MrVALIDinfo/Project_Robo_dog/cardboard/README.md

# Картонный макет 1:1

`instrukciya.pdf` — инструкция по сборке, `raskroy_A4.pdf` / `raskroy_A3.pdf` — шаблоны, `laser_svg/` — файлы для лазера.

Печатать в масштабе 100 %. Картон гофрированный, 3 мм. Под другую толщину шаблоны пересчитываются в `tools/cardboard`.
