MrVALIDinfo/Project_Robo_dog/docs/sources/zakupka.pdf

Spot Micro — список закупки | стр. 1

# Spot Micro — список закупки

Робот-собака на Raspberry Pi 3B. Отмечайте купленное в квадратиках.

## 1. Вычисления и сенсоры

| Компонент | Кол-во | Примечание
☐ | Raspberry Pi 3B | 1 | Радиаторы уже установлены
☐ | microSD 8–16 ГБ | 1 | Class 10 / A1
☐ | SSD 240 ГБ M.2 SATA +
| USB-бокс | 1 | Рекомендуется вместо 2.5": компактнее и легче. 2.5" на
| | | пластину не встанет, нужен отдельный кронштейн
☐ | Pi Camera v2 | 1
☐ | Шлейф камеры 20–30 см | 1 | Стандартный 15-pin CSI
☐ | Крепление камеры (печать) | 1 | На пластине нет штатного места
☐ | MPU-6050 (IMU) | 1

## 2. Привод и механика

| Компонент | Кол-во | Примечание
☐ | PCA9685 | 1 | 16-канальный драйвер сервоприводов, I2C
☐ | Сервопривод PDI-HV5523MG | 12
☐ | Удлинители 3-pin | 12 | Длина по месту, для задних и дальних серв
☐ | Печатные детали Spot Micro | 1 компл.
☐ | Подшипник F625zz | 8 | Указан также в таблице крепежа

## 3. Питание

| Компонент | Кол-во | Примечание
☐ | LiPo 2S 4000 мАч | 1
☐ | UBEC 5V / 5A | 1 | Питание Raspberry Pi
☐ | Выключатель (rocker switch) | 1 | Рассчитан на ток не ниже номинала предохранителя
☐ | Разъёмы XT60 | 1 пара
☐ | Y-разветвитель XT60 | 1
☐ | Предохранитель 15–20 А +
| держатель | 1
☐ | Конденсатор 1000–2200 µF | 1 | Напряжение от 16 В, на линию питания серв
☐ | Провод 14–16 AWG | ~1–2 м | Силикон, красный + чёрный
☐ | Зарядное с балансиром | 1 | Для 2S LiPo
☐ | Пищалка разряда | 1 | LiPo low voltage alarm

Spot Micro — список закупки | стр. 2

## 4. Голос

| Компонент | Кол-во | Примечание
☐ | USB-микрофон | 1
☐ | USB-динамик | 1 | Альтернатива: USB-звуковая карта + пассивный динамик с усилителем

## 5. Опционально

| Компонент | Кол-во | Примечание
☐ | LCD 16×2 с I2C-модулем | 1
☐ | ADS1115 | 1 | Замер напряжения батареи

## 6. Крепёж

| Компонент | Кол-во | Примечание
☐ | Болт M5×15 | 8
☐ | Болт M4×20 | 40
☐ | Болт M4×15 | 8
☐ | Гайка M4 | 48
☐ | Болт M3×20 | 4
☐ | Болт M3×10 | 26
☐ | Гайка M3 | 14
☐ | Болт M2.5×10 | 4 | Плата Raspberry Pi
☐ | Гайка M2.5 | 4 | Плата Raspberry Pi
☐ | Винт M2×6 | 4 | Крепление камеры
☐ | Гайка M2 | 4 | Крепление камеры
☐ | Подшипник F625zz | 8
