MrVALIDinfo/Project_Robo_dog/cardboard/raskroy_A3.pdf

Робособака из картона — раскрой 1:1 | Лист 1 из 6 · A3
КОРПУС · деталей на листе: 6 | Картон 3 мм (прорези = 3 мм) · —— резать по контуру · ■ серое — вырезать насквозь · ⊕ отверстие Ø4 под шпажку · - - - разметка, не резать

КОНТРОЛЬ: ровно 100 мм. Печатать в масштабе 100% («Фактический размер») Сторона с надписью — НАРУЖУ (на собранной модели надпись видна). github.com/MrVALIDinfo/Project_Robo_dog

К4

# Крыша (съёмная)

### к носу

К3

# Днище

### к носу

К6

# Нос нижний

К8

# Корма нижняя

# ALA-TOO

К5

## Нос верхний

К7
Корма верхняя

Робособака из картона — раскрой 1:1 | Лист 2 из 6 · A3
КОРПУС · деталей на листе: 4 | Картон 3 мм (прорези = 3 мм) · —— резать по контуру · ■ серое — вырезать насквозь · ⊕ отверстие Ø4 под шпажку · - - - разметка, не резать

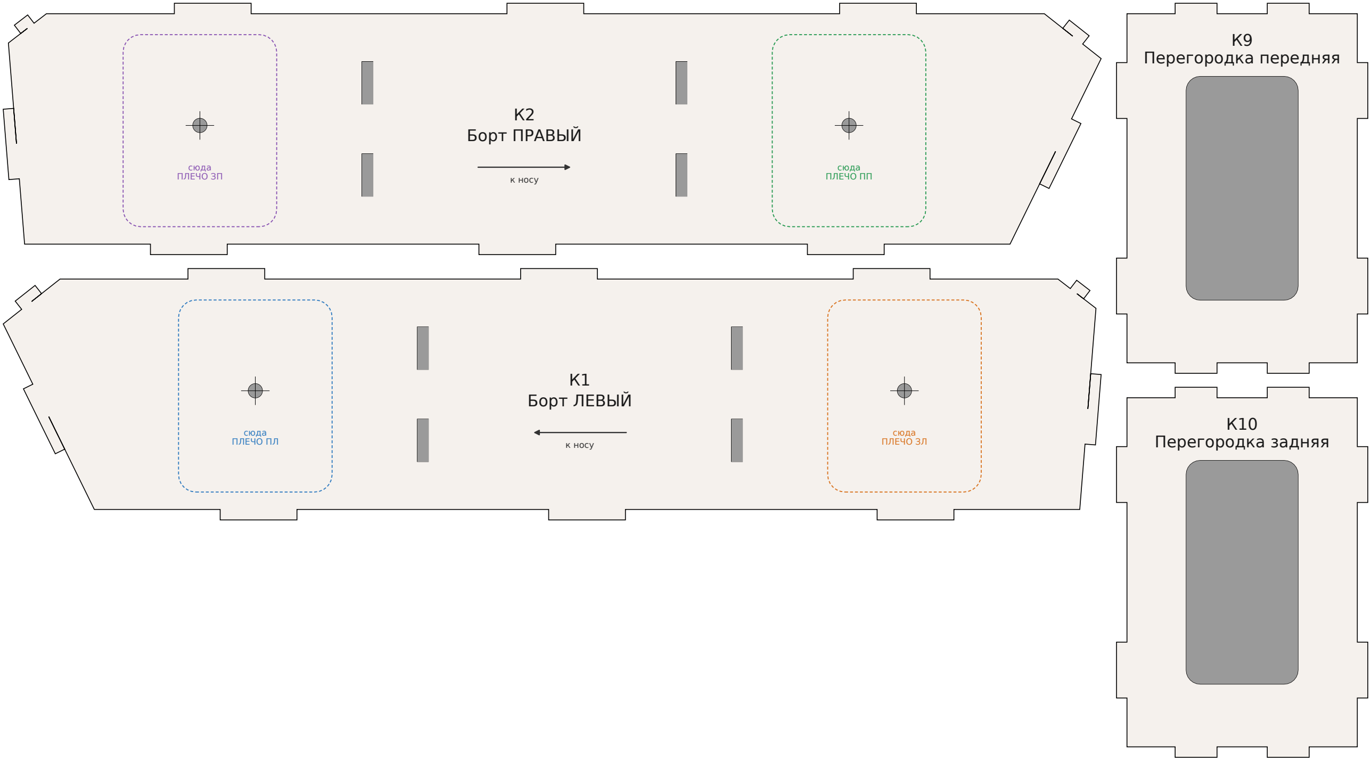
[picture p14: figure]
сюда ПЛЕЧО ПП; сюда ПЛЕЧО ЗП; К2 Борт ПРАВЫЙ; к носу; сюда ПЛЕЧО ПЛ; сюда ПЛЕЧО ЗЛ; К1 Борт ЛЕВЫЙ; К9 Перегородка передняя; К10 Перегородка задняя

Робособака из картона — раскрой 1:1 | Лист 3 из 6 · A3
ПЕРЕДНЯЯ ЛЕВАЯ лапа (ПЛ) · деталей на листе: 21 | Картон 3 мм (прорези = 3 мм) · —— резать по контуру · ■ серое — вырезать насквозь · ⊕ отверстие Ø4 под шпажку · - - - разметка, не резать

## ПЛ-Б1 Бедро, внутренняя передняя ЛЕВАЯ

## ПЛ-Б2

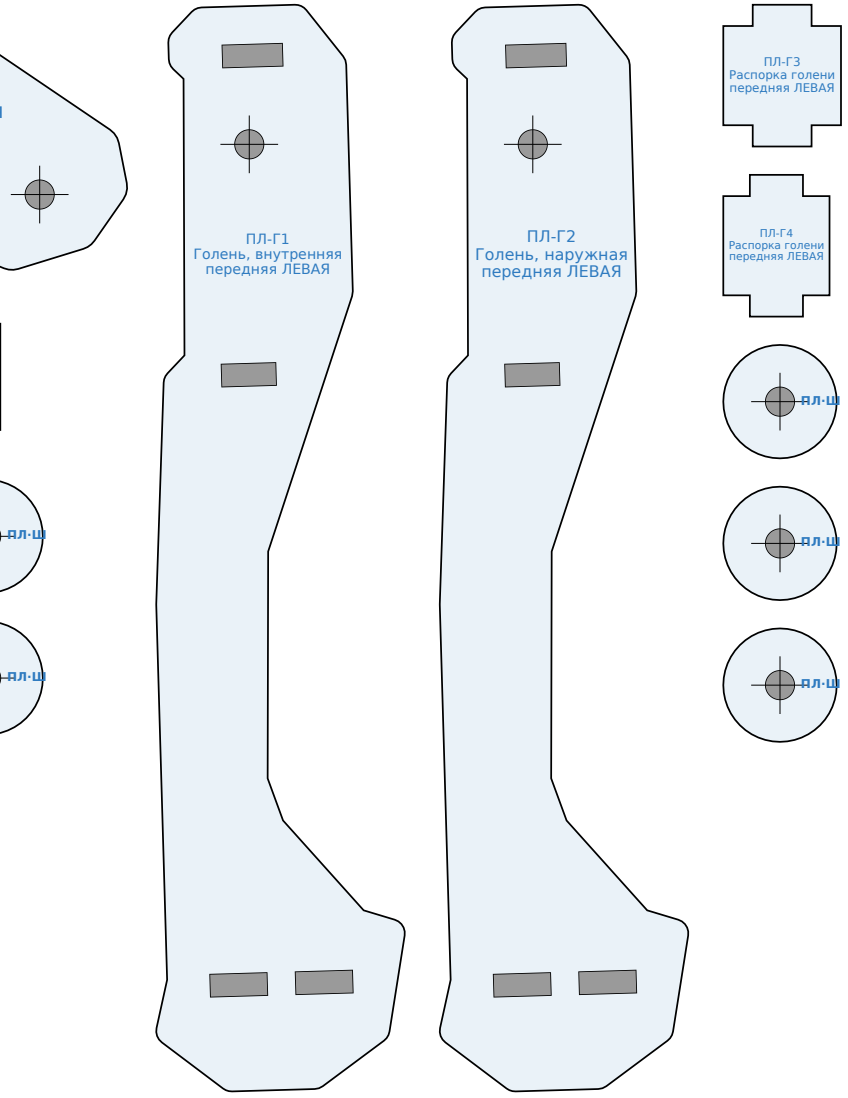
[picture p15: figure]
ПЛ-Г1 Голень, внутренняя передняя ЛЕВАЯ; ПЛ-Г2 Голень, наружная передняя ЛЕВАЯ; ПЛ-Г3 Распорка голени передняя ЛЕВАЯ; ПЛ-Г4 Распорка голени передняя ЛЕВАЯ

## Бедро, наружная передняя ЛЕВАЯ

## ПЛ-П1 Плечо, к корпусу передняя ЛЕВАЯ

## ПЛ-П2 Плечо, наружная передняя ЛЕВАЯ

## ПЛ-Б5 Распорка бедра передняя ЛЕВАЯ

## ПЛ-Б4 Распорка бедра передняя ЛЕВАЯ

## ПЛ-П3 Распорка плеча передняя ЛЕВАЯ

## ПЛ-П4 Распорка плеча передняя ЛЕВАЯ

## ПЛ-Б3 Распорка бедра передняя ЛЕВАЯ

## ПЛ-Г5 Распорка голени передняя ЛЕВАЯ

ПЛ·Ш
ПЛ·Ш

Робособака из картона — раскрой 1:1 | Лист 4 из 6 · A3
ПЕРЕДНЯЯ ПРАВАЯ лапа (ПП) · деталей на листе: 21 | Картон 3 мм (прорези = 3 мм) · —— резать по контуру · ■ серое — вырезать насквозь · ⊕ отверстие Ø4 под шпажку · - - - разметка, не резать

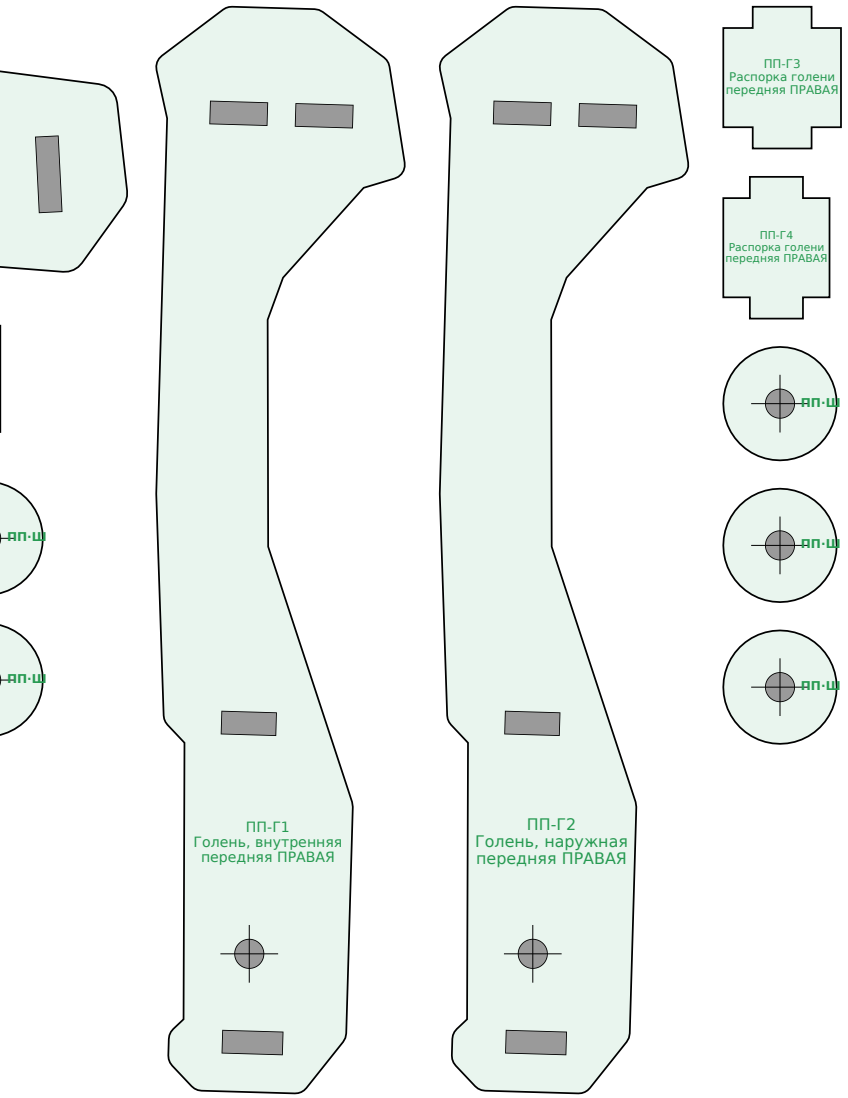
[picture p16: figure]
ПП-Г1 Голень, внутренняя передняя ПРАВАЯ; ПП-Г2 Голень, наружная передняя ПРАВАЯ; ПП-Г3 Распорка голени передняя ПРАВАЯ; ПП-Г4 Распорка голени передняя ПРАВАЯ

## ПП-Б1 Бедро, внутренняя передняя ПРАВАЯ

## ПП-Б2 Бедро, наружная передняя ПРАВАЯ

## ПП-П1 Плечо, к корпусу передняя ПРАВАЯ

## ПП-П2 Плечо, наружная передняя ПРАВАЯ

## ПП-Б5 Распорка бедра передняя ПРАВАЯ

## ПП-Б4 Распорка бедра передняя ПРАВАЯ

## ПП-П3 Распорка плеча передняя ПРАВАЯ

## ПП-П4 Распорка плеча передняя ПРАВАЯ

## ПП-Б3 Распорка бедра передняя ПРАВАЯ

## ПП-Г5 Распорка голени передняя ПРАВАЯ

ПП·Ш
ПП·Ш

Робособака из картона — раскрой 1:1 | Лист 5 из 6 · A3
ЗАДНЯЯ ЛЕВАЯ лапа (ЗЛ) · деталей на листе: 21 | Картон 3 мм (прорези = 3 мм) · —— резать по контуру · ■ серое — вырезать насквозь · ⊕ отверстие Ø4 под шпажку · - - - разметка, не резать

## ЗЛ-Б1 Бедро, внутренняя задняя ЛЕВАЯ

## ЗЛ-Б2

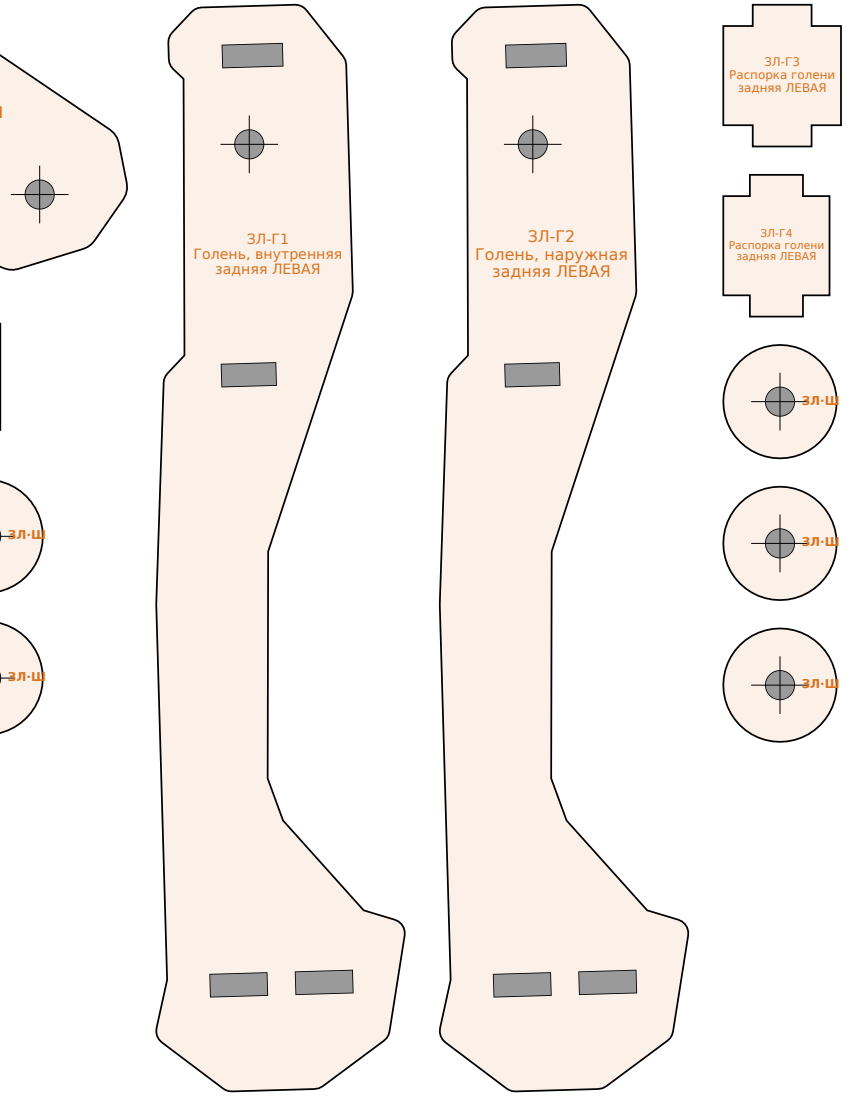
[picture p17: figure]
ЗЛ-Г1 Голень, внутренняя задняя ЛЕВАЯ; ЗЛ-Г2 Голень, наружная задняя ЛЕВАЯ; ЗЛ-Г3 Распорка голени задняя ЛЕВАЯ; ЗЛ-Г4 Распорка голени задняя ЛЕВАЯ

## Бедро, наружная задняя ЛЕВАЯ

## ЗЛ-П1 Плечо, к корпусу задняя ЛЕВАЯ

## ЗЛ-П2 Плечо, наружная задняя ЛЕВАЯ

## ЗЛ-Б5 Распорка бедра задняя ЛЕВАЯ

## ЗЛ-Б4 Распорка бедра задняя ЛЕВАЯ

## ЗЛ-П3 Распорка плеча задняя ЛЕВАЯ

## ЗЛ-П4 Распорка плеча задняя ЛЕВАЯ

## ЗЛ-Б3 Распорка бедра задняя ЛЕВАЯ

## ЗЛ-Г5 Распорка голени задняя ЛЕВАЯ

ЗЛ·Ш
ЗЛ·Ш

Робособака из картона — раскрой 1:1 | Лист 6 из 6 · A3
ЗАДНЯЯ ПРАВАЯ лапа (ЗП) · деталей на листе: 21 | Картон 3 мм (прорези = 3 мм) · —— резать по контуру · ■ серое — вырезать насквозь · ⊕ отверстие Ø4 под шпажку · - - - разметка, не резать

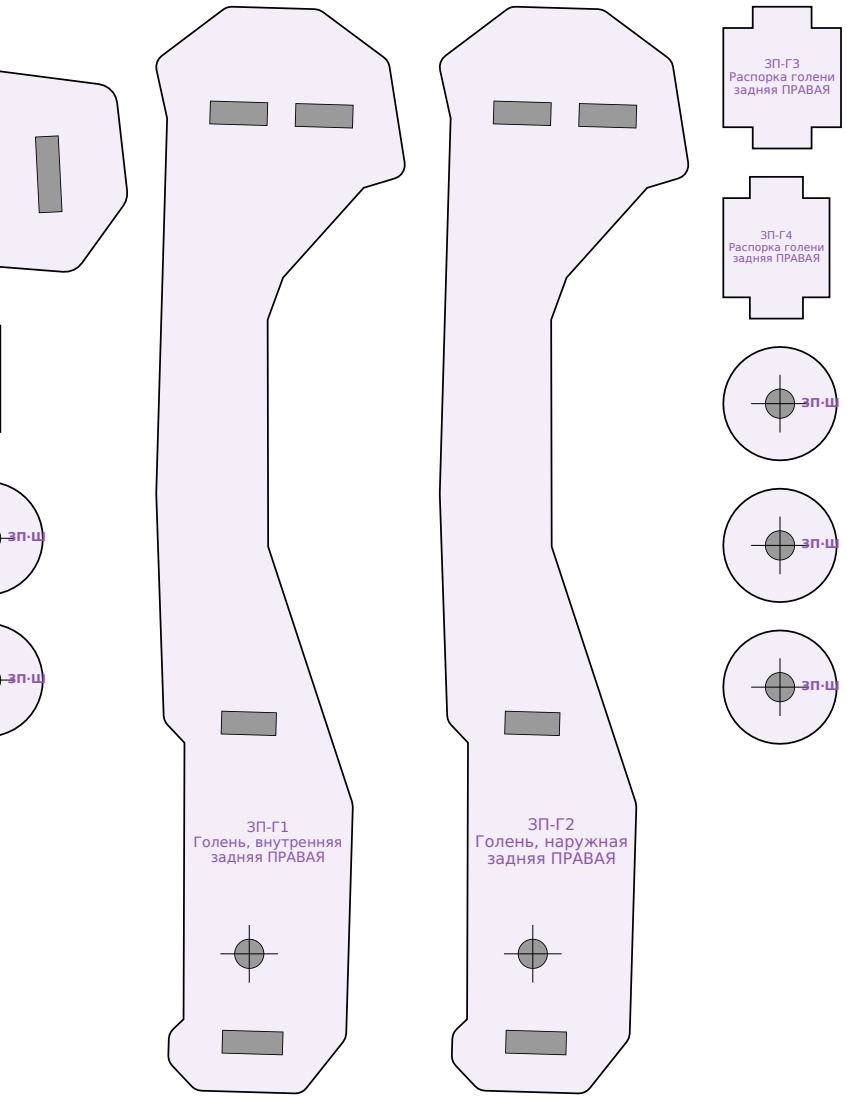
[picture p18: figure]
ЗП-Г1 Голень, внутренняя задняя ПРАВАЯ; ЗП-Г2 Голень, наружная задняя ПРАВАЯ; ЗП-Г3 Распорка голени задняя ПРАВАЯ; ЗП-Г4 Распорка голени задняя ПРАВАЯ

## ЗП-Б1 Бедро, внутренняя задняя ПРАВАЯ

## ЗП-Б2 Бедро, наружная задняя ПРАВАЯ

## ЗП-П1 Плечо, к корпусу задняя ПРАВАЯ

## ЗП-П2 Плечо, наружная задняя ПРАВАЯ

## ЗП-Б5 Распорка бедра задняя ПРАВАЯ

## ЗП-Б4 Распорка бедра задняя ПРАВАЯ

## ЗП-П3 Распорка плеча задняя ПРАВАЯ

## ЗП-П4 Распорка плеча задняя ПРАВАЯ

## ЗП-Б3 Распорка бедра задняя ПРАВАЯ

## ЗП-Г5 Распорка голени задняя ПРАВАЯ

ЗП·Ш
ЗП·Ш
