MrVALIDinfo/Project_Robo_dog/cardboard/raskroy_A4.pdf

Робособака из картона — раскрой 1:1 | Лист 1 из 9 · A4
КОРПУС · деталей на листе: 4 | Картон 3 мм (прорези = 3 мм) · —— резать по контуру · ■ серое — вырезать насквозь · ⊕ отверстие Ø4 под шпажку · - - - разметка, не резать

КОНТРОЛЬ: ровно 100 мм. Печатать в масштабе 100% («Фактический размер») Сторона с надписью — НАРУЖУ (на собранной модели надпись видна). github.com/MrVALIDinfo/Project_Robo_dog

СТЫК с частью 2/2 — не резать, склеить скотчем

К4 (1/2)

# Крыша (съёмная)

### к носу

К6

# Нос нижний

К5

## Нос верхний

К7
Корма верхняя

Робособака из картона — раскрой 1:1 | Лист 2 из 9 · A4
КОРПУС · деталей на листе: 2 | Картон 3 мм (прорези = 3 мм) · —— резать по контуру · ■ серое — вырезать насквозь · ⊕ отверстие Ø4 под шпажку · - - - разметка, не резать

СТЫК с частью 2/2 — не резать, склеить скотчем

К3 (1/2)

# Днище

### к носу

К8

# Корма нижняя

# ALA-TOO

Робособака из картона — раскрой 1:1 | Лист 3 из 9 · A4
КОРПУС · деталей на листе: 2 | Картон 3 мм (прорези = 3 мм) · —— резать по контуру · ■ серое — вырезать насквозь · ⊕ отверстие Ø4 под шпажку · - - - разметка, не резать

Сторона с надписью — НАРУЖУ (на собранной модели надпись видна). github.com/MrVALIDinfo/Project_Robo_dog СТЫК с частью ¹/2 — не резать, склеить скотчем

К4 (2/2)

# Крыша (съёмная)

### к носу

СТЫК с частью 1/2 — не резать, склеить скотчем

К3 (2/2)

# Днище

### к носу

Робособака из картона — раскрой 1:1 | Лист 4 из 9 · A4
КОРПУС · деталей на листе: 4 | Картон 3 мм (прорези = 3 мм) · —— резать по контуру · ■ серое — вырезать насквозь · ⊕ отверстие Ø4 под шпажку · - - - разметка, не резать

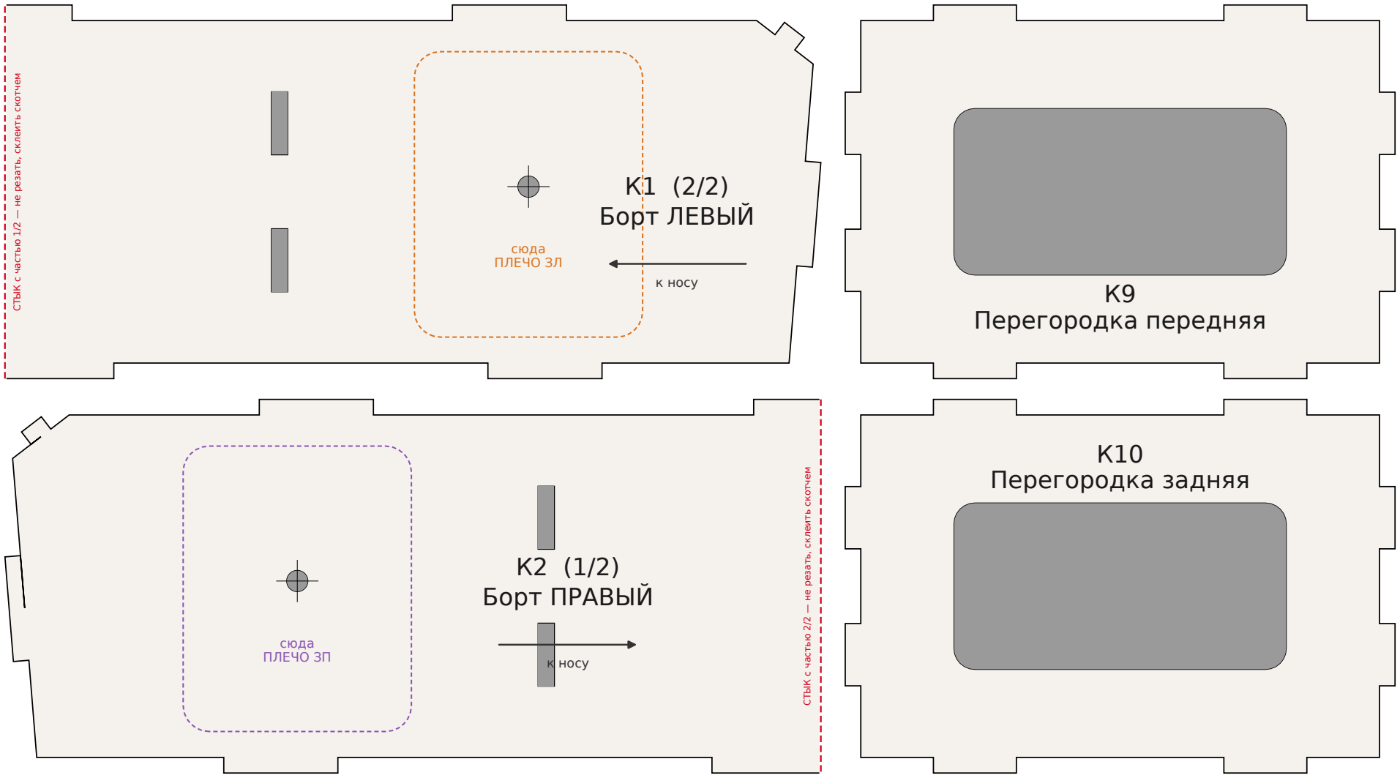
[picture p19: figure]
сюда ПЛЕЧО ЗЛ; К1 (2/2) Борт ЛЕВЫЙ; к носу; сюда ПЛЕЧО ЗП; К2 (1/2) Борт ПРАВЫЙ; К9 Перегородка передняя; К10 Перегородка задняя

СТЫК с частью 1/2 — не резать, склеить скотчем

СТЫК с частью 2/2 — не резать, склеить скотчем

Робособака из картона — раскрой 1:1 | Лист 5 из 9 · A4
КОРПУС · деталей на листе: 2 | Картон 3 мм (прорези = 3 мм) · —— резать по контуру · ■ серое — вырезать насквозь · ⊕ отверстие Ø4 под шпажку · - - - разметка, не резать

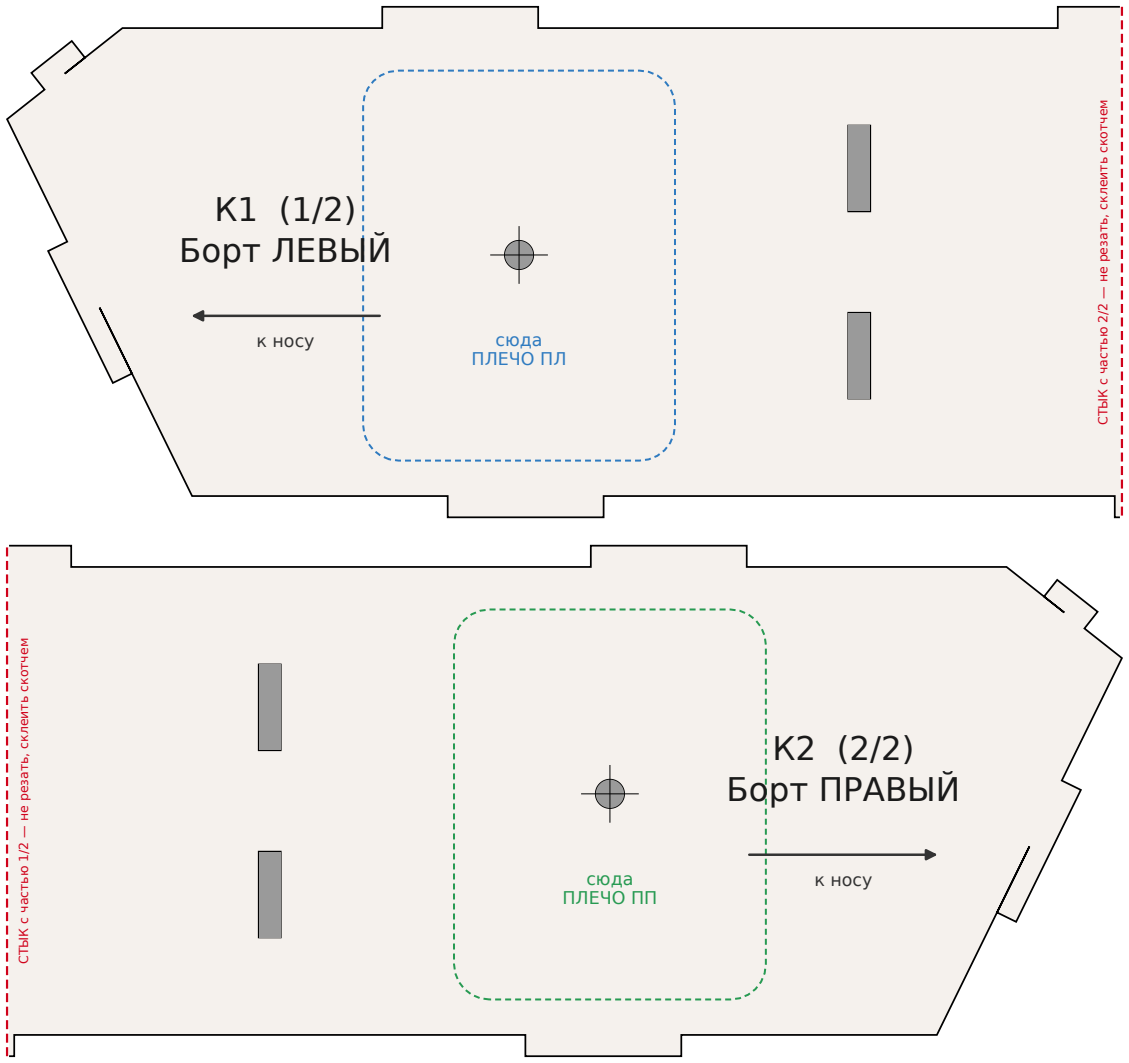
[picture p20: figure]
сюда ПЛЕЧО ПЛ; К1 (1/2) Борт ЛЕВЫЙ; к носу; сюда ПЛЕЧО ПП; К2 (2/2) Борт ПРАВЫЙ

СТЫК с частью 2/2 — не резать, склеить скотчем

СТЫК с частью 1/2 — не резать, склеить скотчем

Робособака из картона — раскрой 1:1 | Лист 6 из 9 · A4
ПЕРЕДНЯЯ ЛЕВАЯ лапа (ПЛ) · деталей на листе: 21 | Картон 3 мм (прорези = 3 мм) · —— резать по контуру · ■ серое — вырезать насквозь · ⊕ отверстие Ø4 под шпажку · - - - разметка, не резать

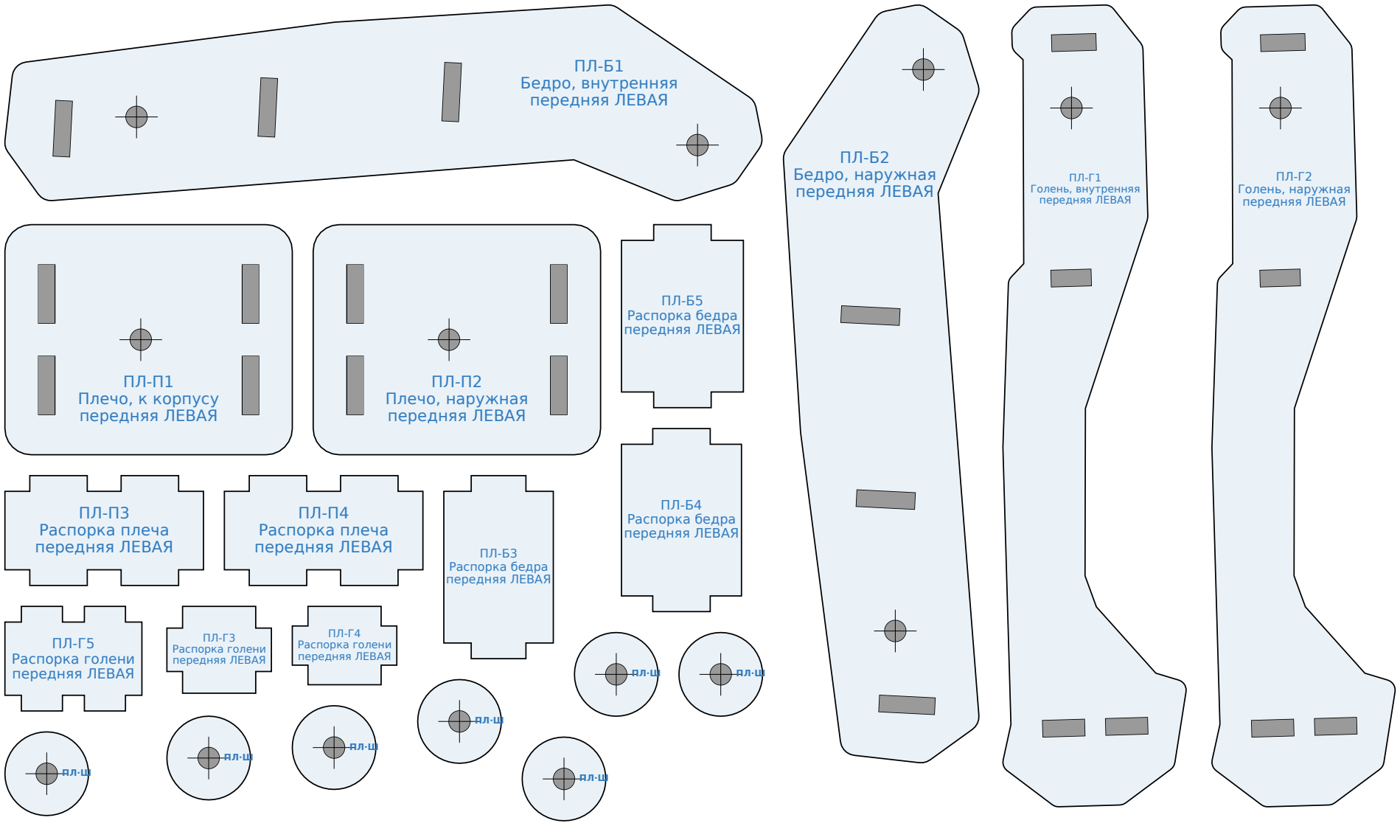
[picture p21: figure]
ПЛ-Б1 Бедро, внутренняя передняя ЛЕВАЯ; ПЛ-Б2 Бедро, наружная передняя ЛЕВАЯ; ПЛ-Г1 Голень, внутренняя передняя ЛЕВАЯ; ПЛ-Г2 Голень, наружная передняя ЛЕВАЯ; ПЛ-П1 Плечо, к корпусу передняя ЛЕВАЯ; ПЛ-П2 Плечо, наружная передняя ЛЕВАЯ; ПЛ-Б5 Распорка бедра передняя ЛЕВАЯ; ПЛ-Б4 Распорка бедра передняя ЛЕВАЯ; ПЛ-П3 Распорка плеча передняя ЛЕВАЯ; ПЛ-П4 Распорка плеча; передняя ЛЕВАЯ; Распорка бедра передняя ЛЕВАЯ; ПЛ-Г5 Распорка голени передняя ЛЕВАЯ; ПЛ-Г3 Распорка голени передняя ЛЕВАЯ; ПЛ-Г4 Распорка голени передняя ЛЕВАЯ

Робособака из картона — раскрой 1:1 | Лист 7 из 9 · A4
ПЕРЕДНЯЯ ПРАВАЯ лапа (ПП) · деталей на листе: 21 | Картон 3 мм (прорези = 3 мм) · —— резать по контуру · ■ серое — вырезать насквозь · ⊕ отверстие Ø4 под шпажку · - - - разметка, не резать

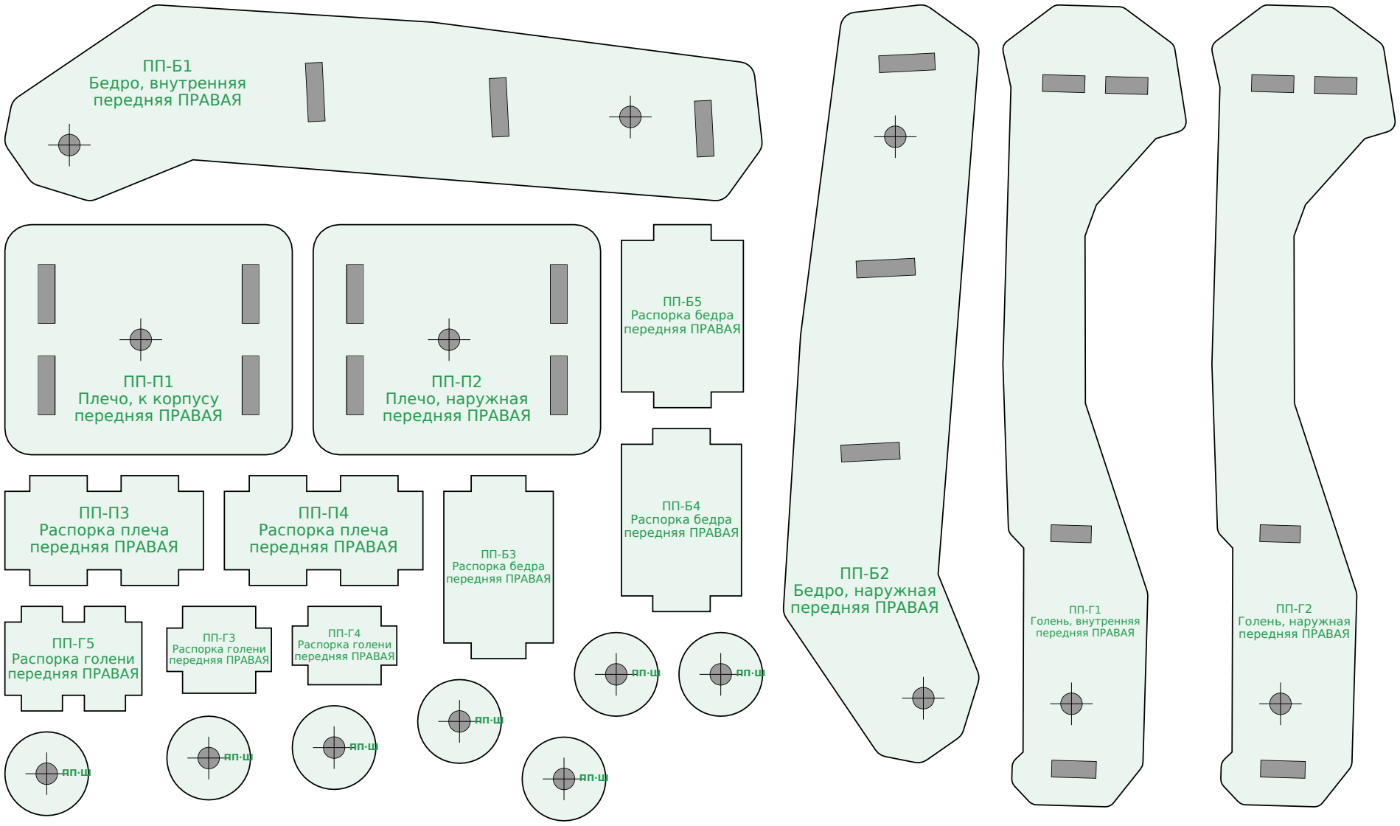
[picture p22: figure]
ПП-Б1 Бедро, внутренняя передняя ПРАВАЯ; ПП-Б2 Бедро, наружная; передняя ПРАВАЯ; Голень, внутренняя передняя ПРАВАЯ; ПП-Г2 Голень, наружная передняя ПРАВАЯ; ПП-П1 Плечо, к корпусу передняя ПРАВАЯ; ПП-П2 Плечо, наружная передняя ПРАВАЯ; ПП-Б5 Распорка бедра передняя ПРАВАЯ; ПП-Б4 Распорка бедра передняя ПРАВАЯ; ПП-П3 Распорка плеча передняя ПРАВАЯ; ПП-П4 Распорка плеча; Распорка бедра передняя ПРАВАЯ; ПП-Г5 Распорка голени передняя ПРАВАЯ; ПП-Г3 Распорка голени передняя ПРАВАЯ; ПП-Г4 Распорка голени передняя ПРАВАЯ

Робособака из картона — раскрой 1:1 | Лист 8 из 9 · A4
ЗАДНЯЯ ЛЕВАЯ лапа (ЗЛ) · деталей на листе: 21 | Картон 3 мм (прорези = 3 мм) · —— резать по контуру · ■ серое — вырезать насквозь · ⊕ отверстие Ø4 под шпажку · - - - разметка, не резать

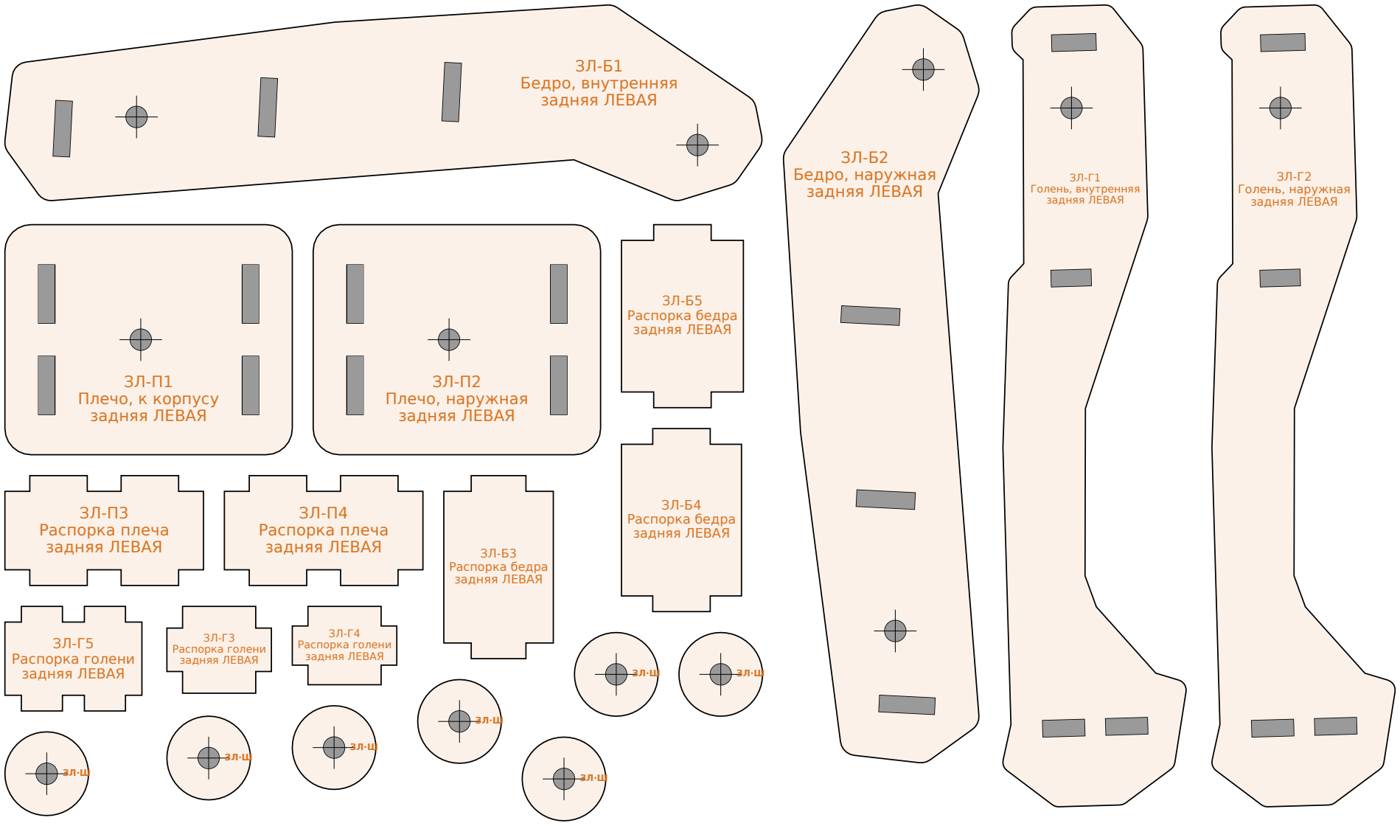
[picture p23: figure]
ЗЛ-Б1 Бедро, внутренняя задняя ЛЕВАЯ; ЗЛ-Б2 Бедро, наружная задняя ЛЕВАЯ; ЗЛ-Г1 Голень, внутренняя задняя ЛЕВАЯ; ЗЛ-Г2 Голень, наружная задняя ЛЕВАЯ; ЗЛ-П1 Плечо, к корпусу задняя ЛЕВАЯ; ЗЛ-П2 Плечо, наружная задняя ЛЕВАЯ; ЗЛ-Б5 Распорка бедра задняя ЛЕВАЯ; ЗЛ-Б4 Распорка бедра задняя ЛЕВАЯ; ЗЛ-П3 Распорка плеча задняя ЛЕВАЯ; ЗЛ-П4 Распорка плеча; задняя ЛЕВАЯ; Распорка бедра задняя ЛЕВАЯ; ЗЛ-Г5 Распорка голени задняя ЛЕВАЯ; ЗЛ-Г3 Распорка голени задняя ЛЕВАЯ; ЗЛ-Г4 Распорка голени задняя ЛЕВАЯ

Робособака из картона — раскрой 1:1 | Лист 9 из 9 · A4
ЗАДНЯЯ ПРАВАЯ лапа (ЗП) · деталей на листе: 21 | Картон 3 мм (прорези = 3 мм) · —— резать по контуру · ■ серое — вырезать насквозь · ⊕ отверстие Ø4 под шпажку · - - - разметка, не резать

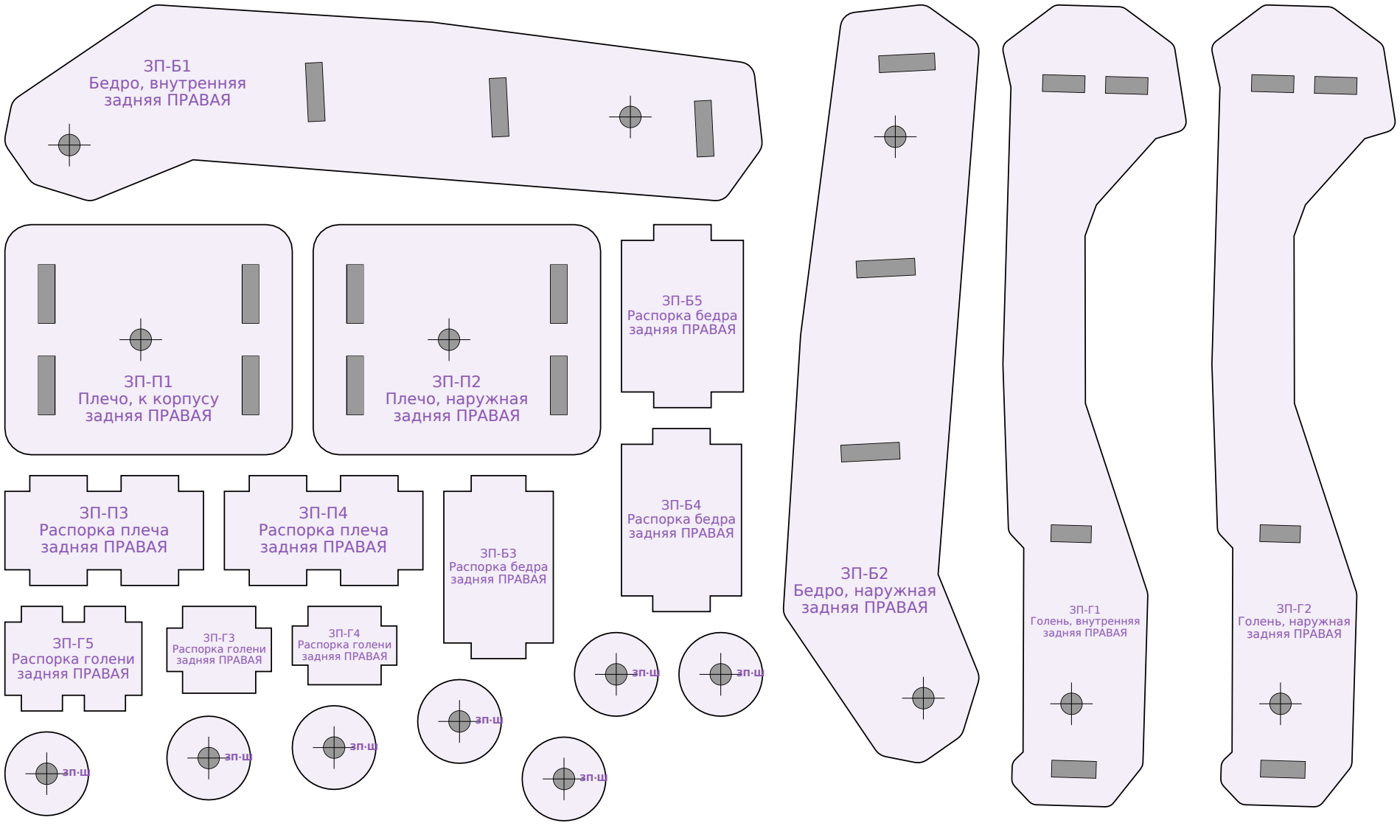
[picture p24: figure]
ЗП-Б1 Бедро, внутренняя задняя ПРАВАЯ; ЗП-Б2 Бедро, наружная; задняя ПРАВАЯ; Голень, внутренняя задняя ПРАВАЯ; ЗП-Г2 Голень, наружная задняя ПРАВАЯ; ЗП-П1 Плечо, к корпусу задняя ПРАВАЯ; ЗП-П2 Плечо, наружная задняя ПРАВАЯ; ЗП-Б5 Распорка бедра задняя ПРАВАЯ; ЗП-Б4 Распорка бедра задняя ПРАВАЯ; ЗП-П3 Распорка плеча задняя ПРАВАЯ; ЗП-П4 Распорка плеча; Распорка бедра задняя ПРАВАЯ; ЗП-Г5 Распорка голени задняя ПРАВАЯ; ЗП-Г3 Распорка голени задняя ПРАВАЯ; ЗП-Г4 Распорка голени задняя ПРАВАЯ
