MrVALIDinfo/Project_Robo_dog/docs/arduino-led-circuit.png

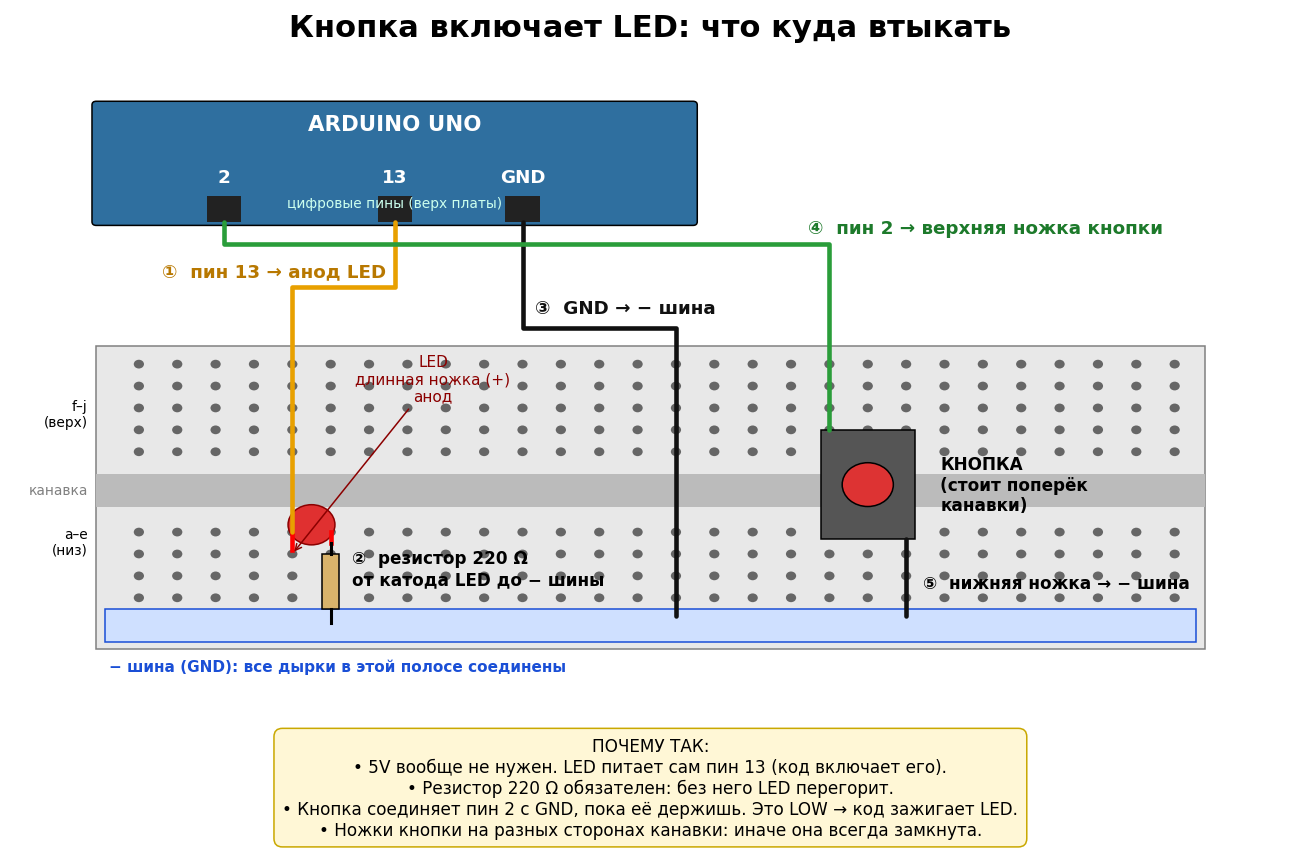
docs/arduino-led-circuit.png
