MrVALIDinfo/Project_Robo_dog/3d-viewer/stl/parts/mainbody__5__R_side_plate.stl

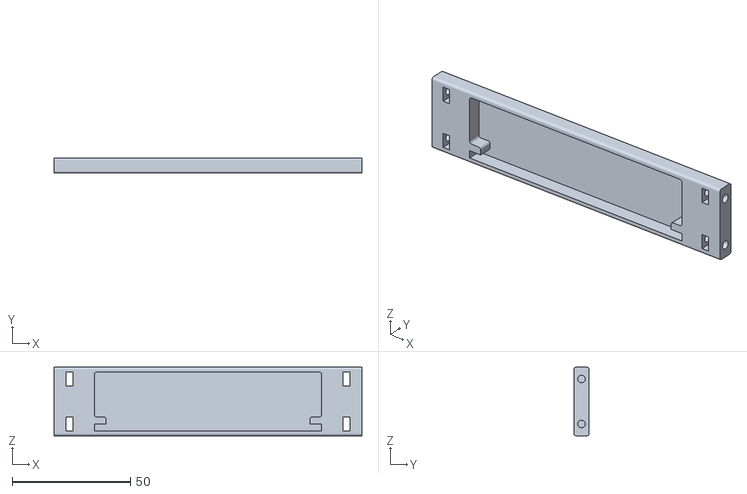
[picture p26: CAD file, 2026-10-31]
3d-viewer/stl/parts/mainbody__5__R_side_plate.stl
130.0 x 6.50 x 29.0
