MrVALIDinfo/Project_Robo_dog/3d-viewer/stl/parts/mainbody__6__plate_plain.stl

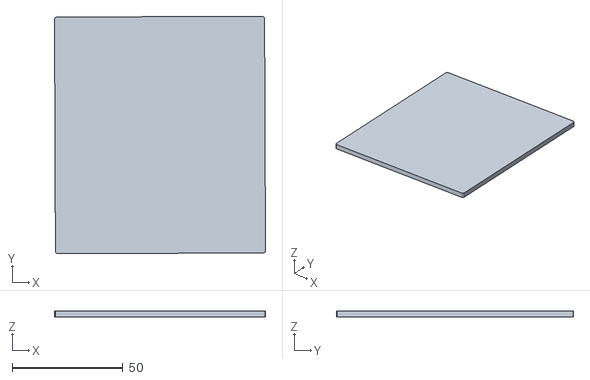
[picture p27: CAD file, 2026-10-31]
3d-viewer/stl/parts/mainbody__6__plate_plain.stl
95.4 x 107.4 x 2.90
