MrVALIDinfo/Project_Robo_dog/3d-viewer/stl/kdy/mainbody.stl

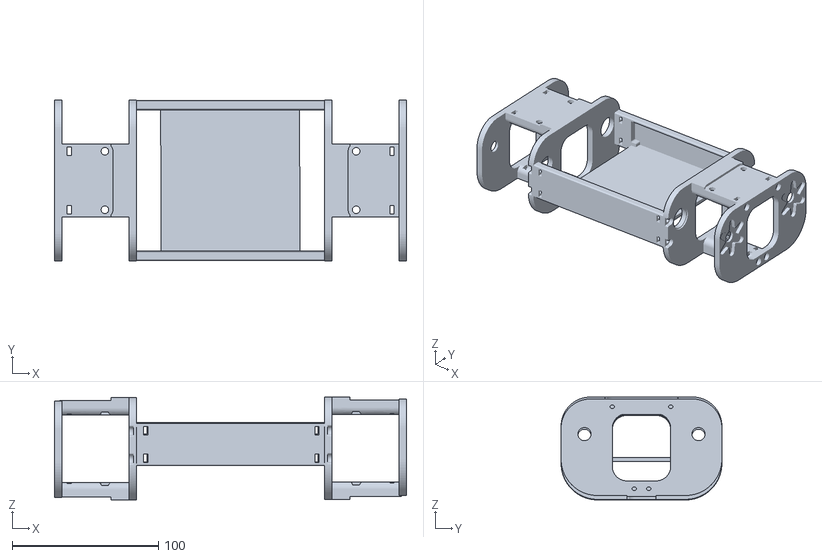
[picture p28: CAD file, 2026-10-30]
3d-viewer/stl/kdy/mainbody.stl
240.7 x 110.0 x 70.4
