MrVALIDinfo/Project_Robo_dog/3d-viewer/stl/parts/mainbody__2__O_shoulder.stl

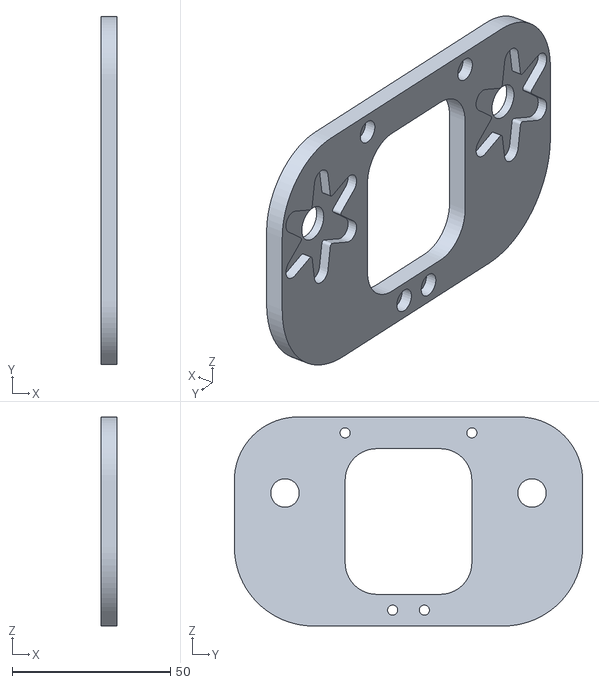
[picture p29: CAD file, 2026-10-31]
3d-viewer/stl/parts/mainbody__2__O_shoulder.stl
5.00 x 110.0 x 66.0
