MrVALIDinfo/Project_Robo_dog/3d-viewer/stl/parts/mainbody__0__I_shoulder_cls.stl

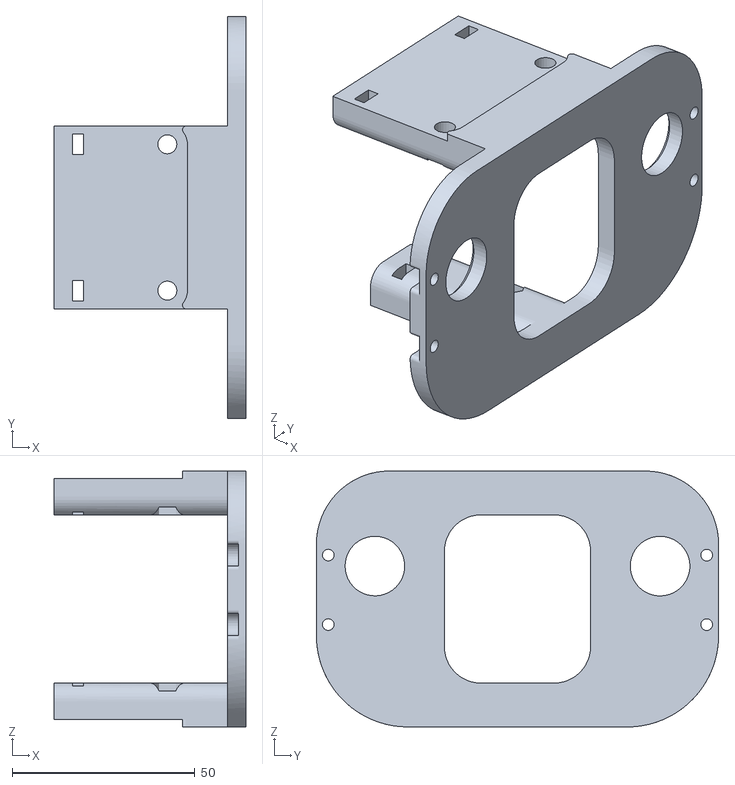
[picture p30: CAD file, 2026-10-31]
3d-viewer/stl/parts/mainbody__0__I_shoulder_cls.stl
52.5 x 110.0 x 70.0
