MrVALIDinfo/Project_Robo_dog/3d-viewer/parts/rpi3.stl

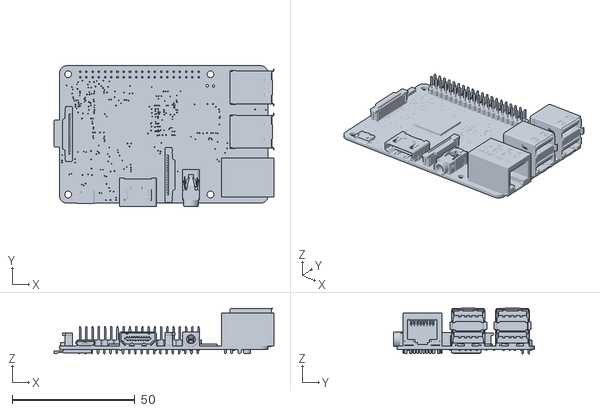
[picture p31: CAD file, 2026-10-31]
3d-viewer/parts/rpi3.stl
89.6 x 57.3 x 18.6
