MrVALIDinfo/Project_Robo_dog/3d-viewer/stl/backpart_filled.stl

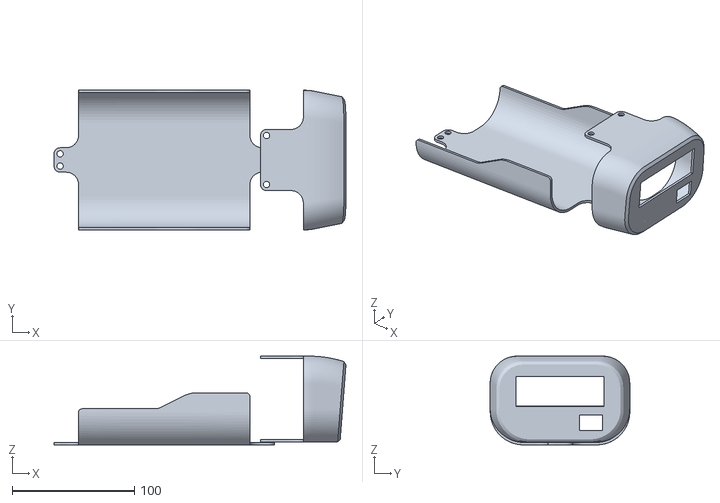
[picture p32: CAD file, 2026-10-26]
3d-viewer/stl/backpart_filled.stl
238.4 x 114.1 x 72.5
