MrVALIDinfo/Project_Robo_dog/3d-viewer/stl/parts/frontpart__1__F_cover.stl

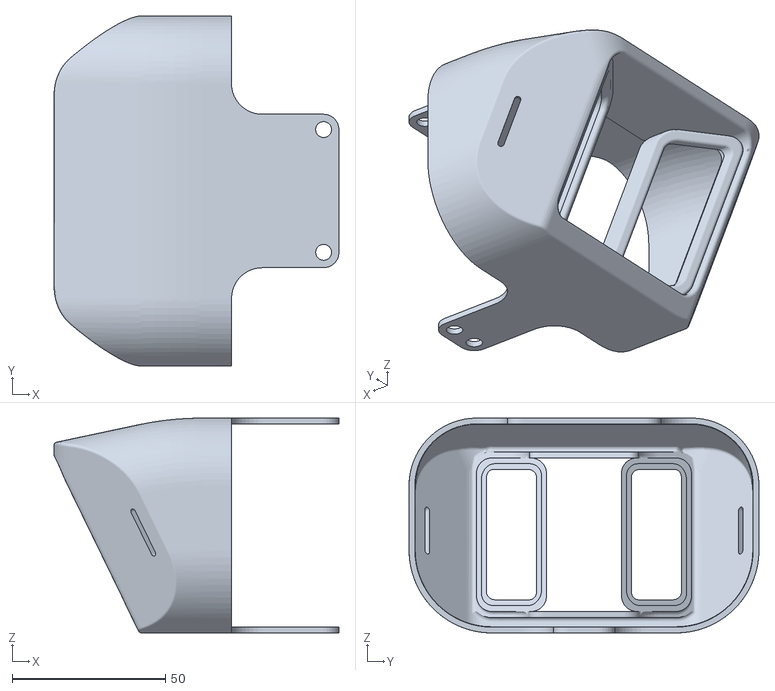
[picture p33: CAD file, 2026-10-31]
3d-viewer/stl/parts/frontpart__1__F_cover.stl
92.8 x 114.0 x 70.0
