MrVALIDinfo/Project_Robo_dog/print/kdy/L_arm_cls_cable.stl

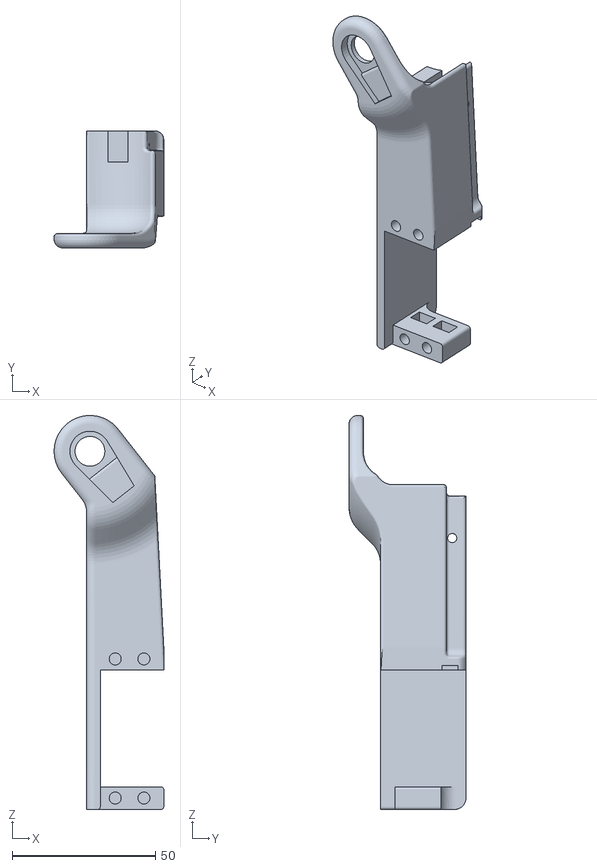
[picture p34: CAD file, 2026-10-30]
print/kdy/L_arm_cls_cable.stl
38.2 x 40.8 x 137.4
