MrVALIDinfo/Project_Robo_dog/print/R_cover_alatoo.stl

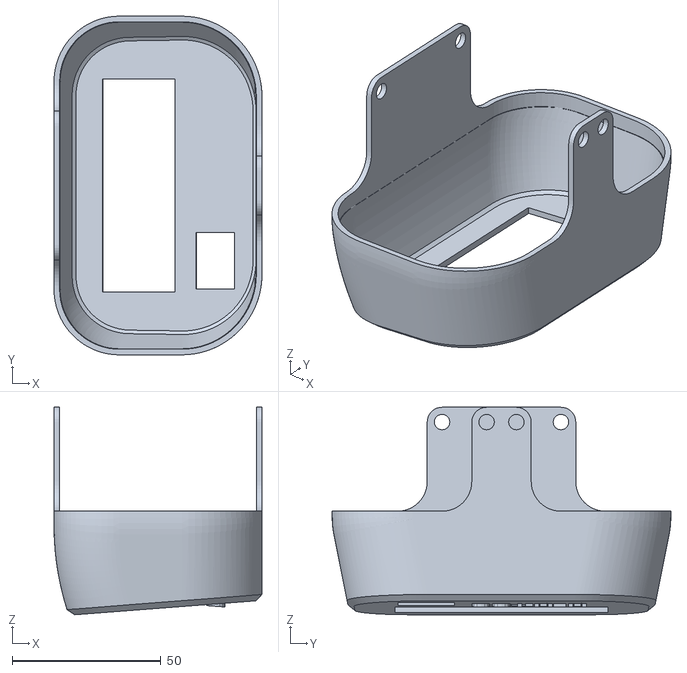
[picture p35: CAD file, 2026-10-30]
print/R_cover_alatoo.stl
70.0 x 114.0 x 69.8
