MrVALIDinfo/Project_Robo_dog/3d-viewer/parts/rear_text.stl

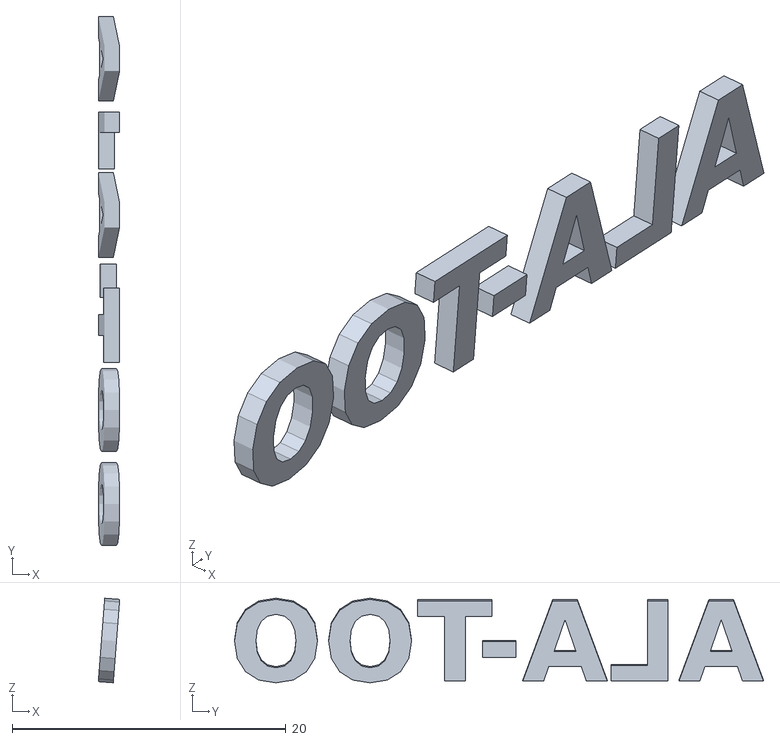
[picture p36: CAD file, 2026-10-30]
3d-viewer/parts/rear_text.stl
1.57 x 38.6 x 6.18
