MrVALIDinfo/Project_Robo_dog/print/cam_mount.stl

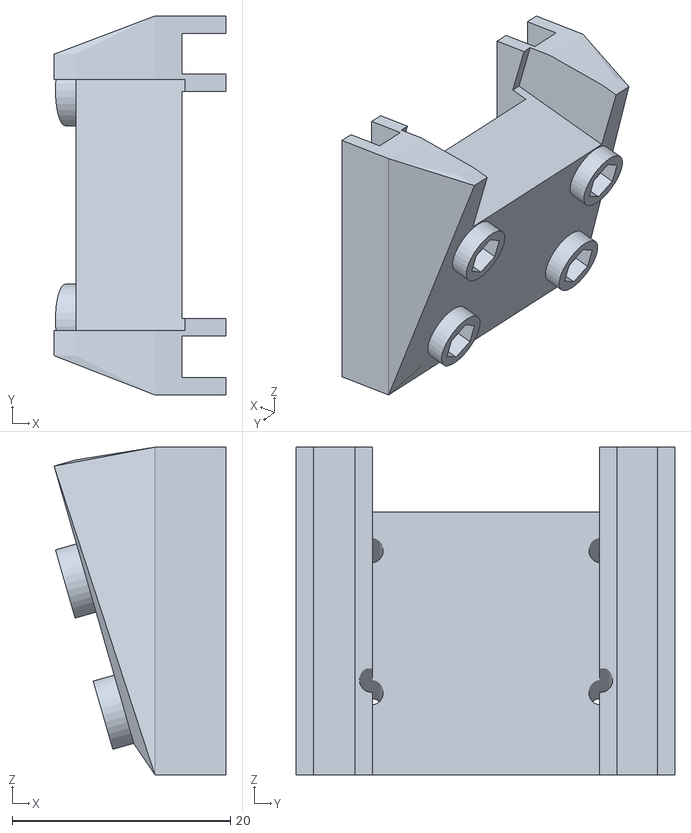
[picture p37: CAD file, 2026-10-26]
print/cam_mount.stl
15.7 x 34.7 x 30.0
