MrVALIDinfo/Project_Robo_dog/3d-viewer/parts/cam_mount.stl

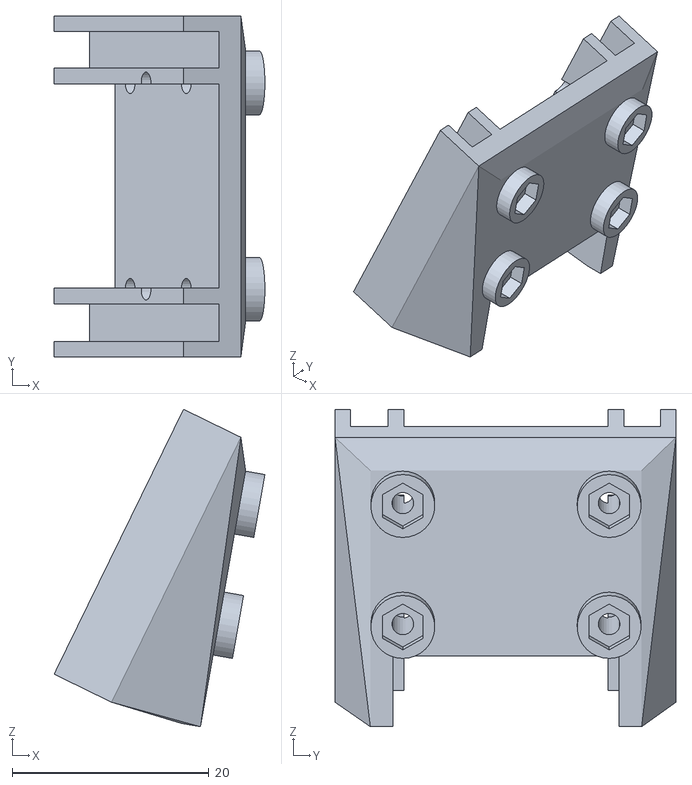
[picture p38: CAD file, 2026-10-26]
3d-viewer/parts/cam_mount.stl
21.5 x 34.7 x 32.3
