MrVALIDinfo/Project_Robo_dog/3d-viewer/stl/parts/rfoot__0__R_wrist_cls.stl

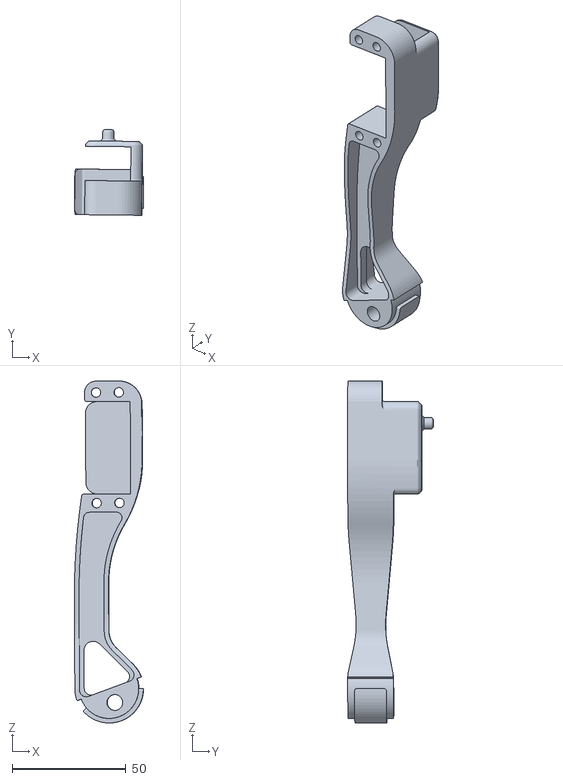
[picture p39: CAD file, 2026-10-31]
3d-viewer/stl/parts/rfoot__0__R_wrist_cls.stl
30.4 x 37.6 x 150.0
