MrVALIDinfo/Project_Robo_dog/3d-viewer/parts/rear_patch.stl

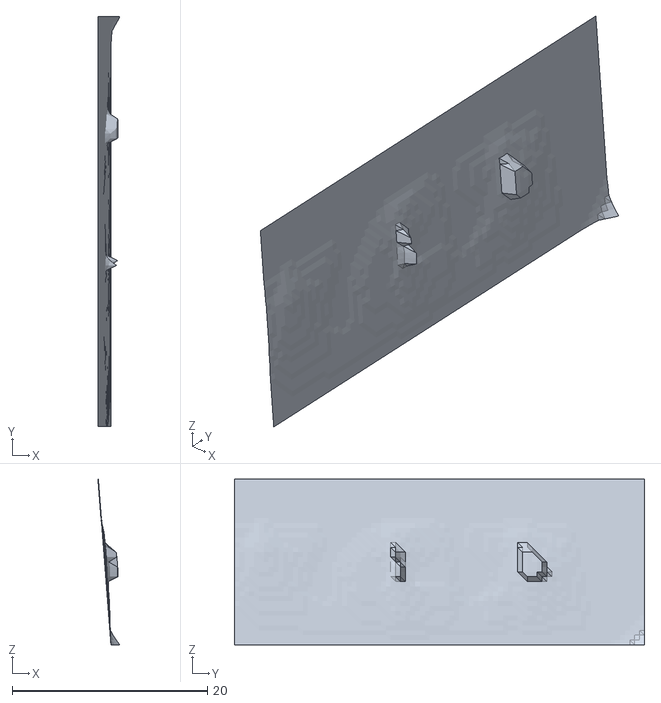
[picture p40: CAD file, 2026-10-21]
3d-viewer/parts/rear_patch.stl
2.23 x 42.0 x 17.0
