MrVALIDinfo/Project_Robo_dog/3d-viewer/stl/kdy/lshoulder.stl

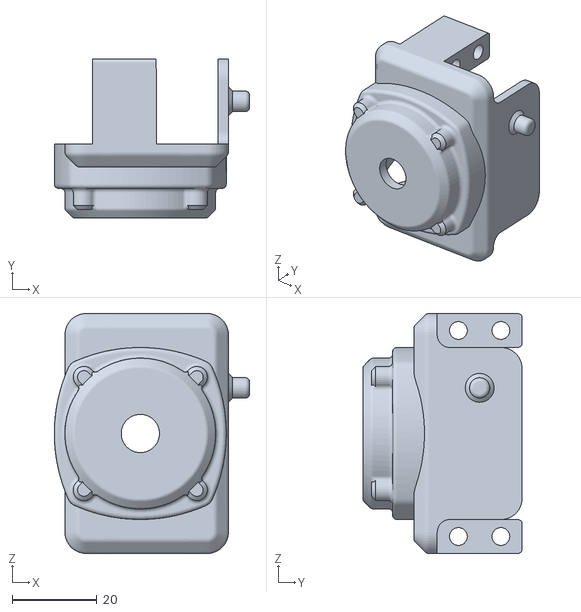
[picture p41: CAD file, 2026-10-30]
3d-viewer/stl/kdy/lshoulder.stl
46.0 x 37.5 x 56.5
