MrVALIDinfo/Project_Robo_dog/print/kdy/servo_board_platform.stl

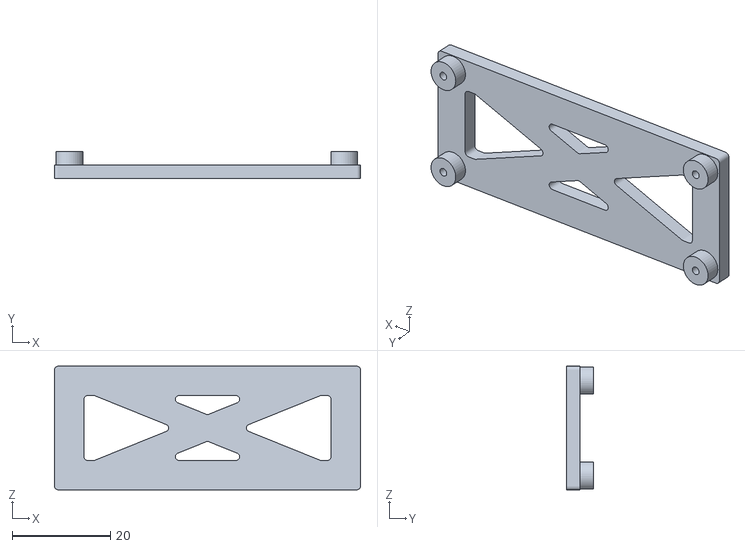
[picture p42: CAD file, 2026-10-30]
print/kdy/servo_board_platform.stl
62.4 x 5.50 x 25.2
