MrVALIDinfo/Project_Robo_dog/3d-viewer/parts/pca_c.stl

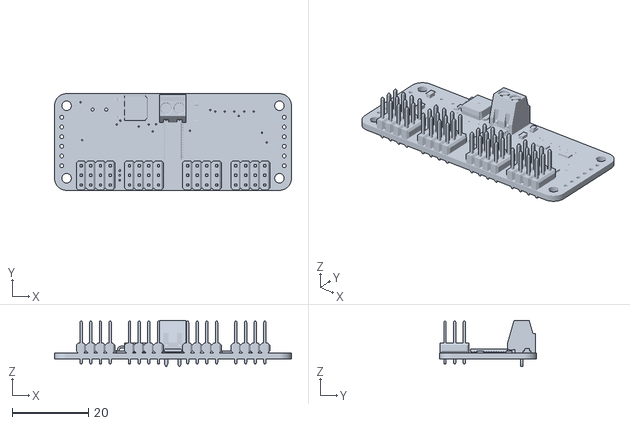
[picture p43: CAD file, 2026-10-21]
3d-viewer/parts/pca_c.stl
62.2 x 25.4 x 12.1
