MrVALIDinfo/Project_Robo_dog/3d-viewer/stl/kdy/frontpart.stl

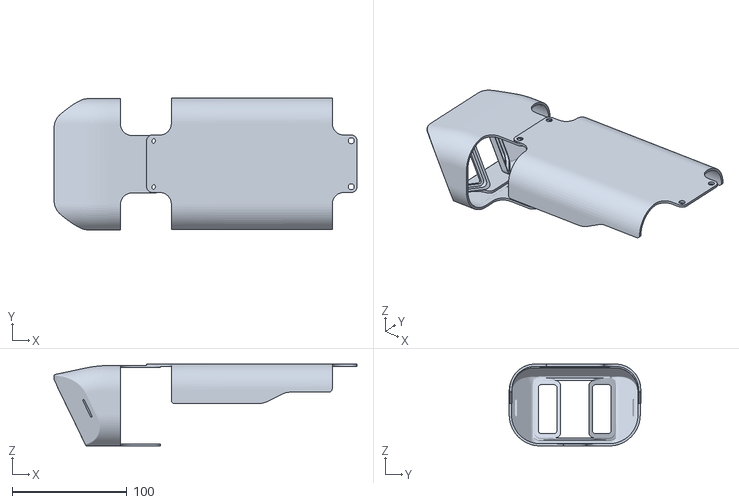
[picture p44: CAD file, 2026-10-30]
3d-viewer/stl/kdy/frontpart.stl
263.5 x 114.5 x 71.2
