MrVALIDinfo/Project_Robo_dog/3d-viewer/stl/parts/backpart__0__non-mega_B_cover_cls.stl

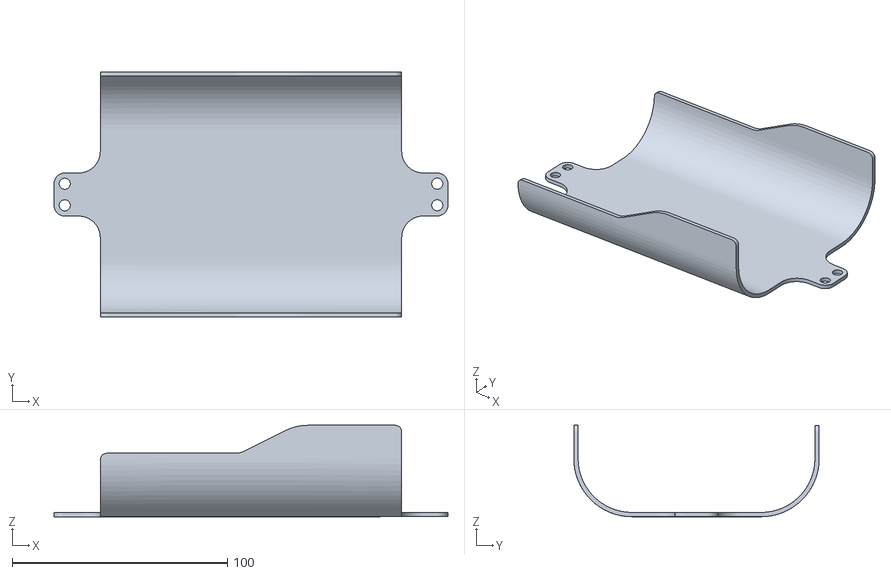
[picture p45: CAD file, 2026-10-31]
3d-viewer/stl/parts/backpart__0__non-mega_B_cover_cls.stl
183.0 x 114.0 x 42.5
