MrVALIDinfo/Project_Robo_dog/print/kdy/raspberry_pi_platform.stl

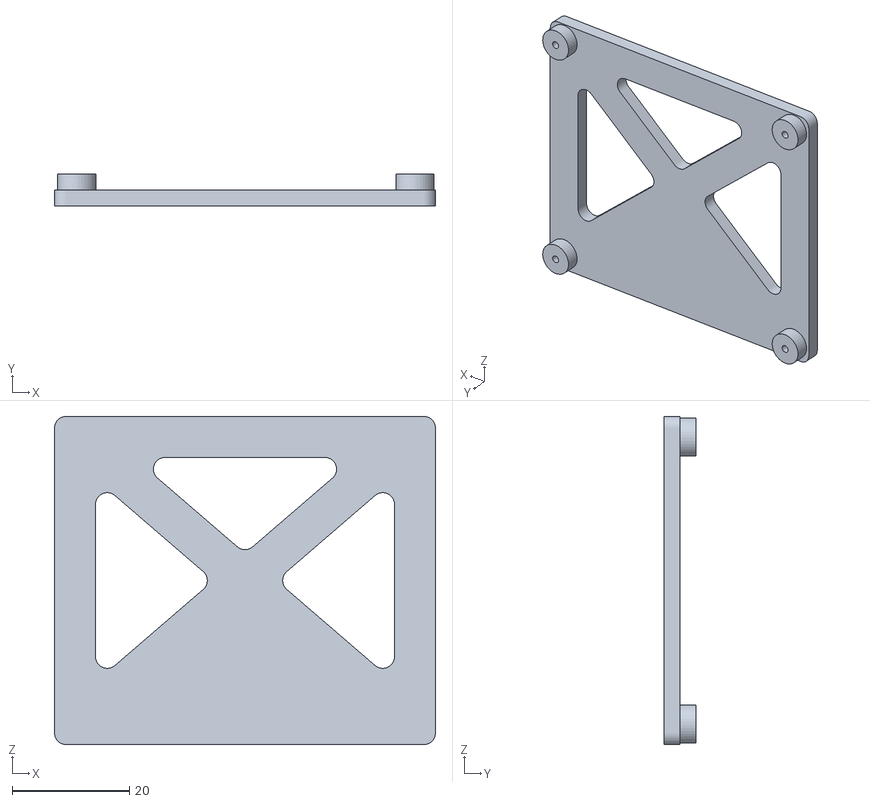
[picture p46: CAD file, 2026-10-30]
print/kdy/raspberry_pi_platform.stl
65.0 x 5.50 x 56.0
