MrVALIDinfo/Project_Robo_dog/3d-viewer/parts/pi_c.stl

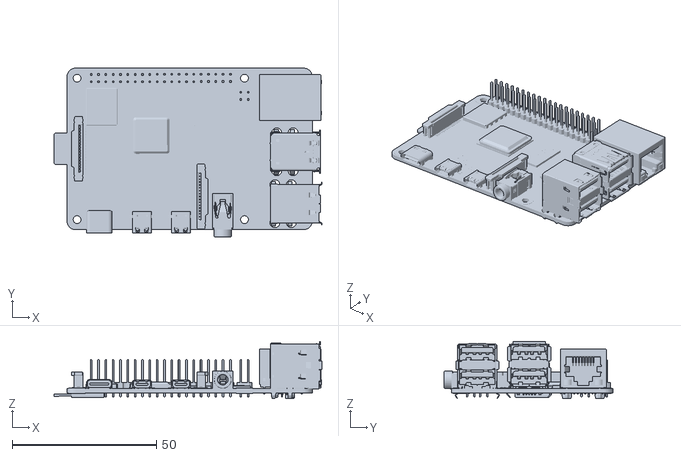
[picture p47: CAD file, 2026-10-21]
3d-viewer/parts/pi_c.stl
92.9 x 58.5 x 19.9
