MrVALIDinfo/Project_Robo_dog/print/kdy/shoulder_reinforcement.stl

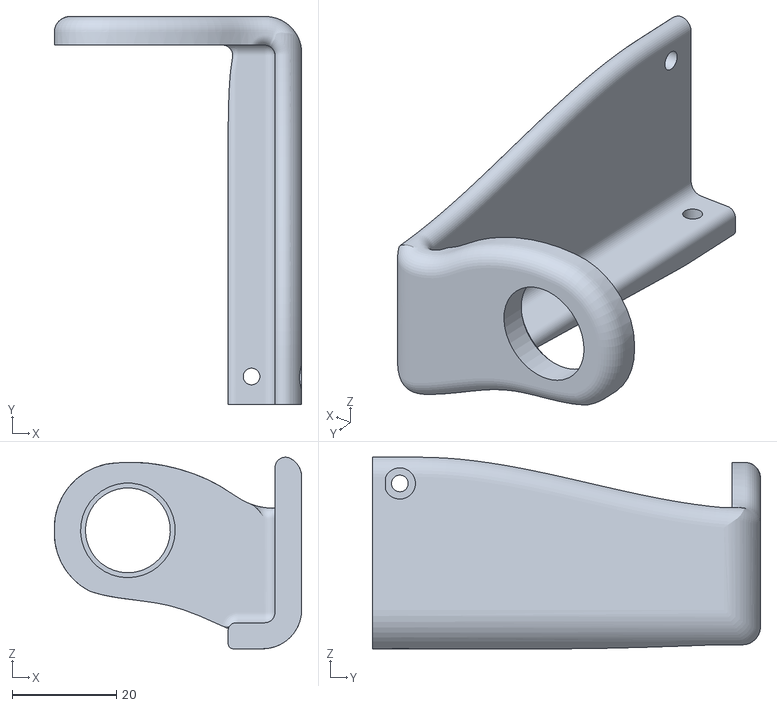
[picture p48: CAD file, 2026-10-30]
print/kdy/shoulder_reinforcement.stl
47.5 x 74.5 x 36.8
