MrVALIDinfo/Project_Robo_dog/3d-viewer/stl/kdy/rarm_cover.stl

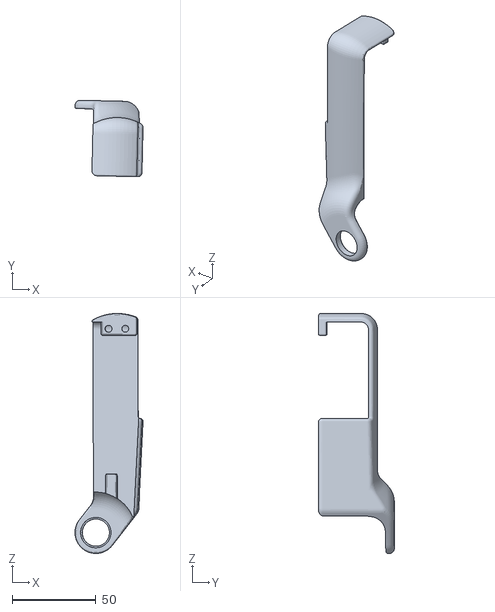
[picture p49: CAD file, 2026-10-30]
3d-viewer/stl/kdy/rarm_cover.stl
40.7 x 45.7 x 143.6
