MrVALIDinfo/Project_Robo_dog/3d-viewer/stl/parts/frontpart__0__non-mega_T_cover_cls.stl

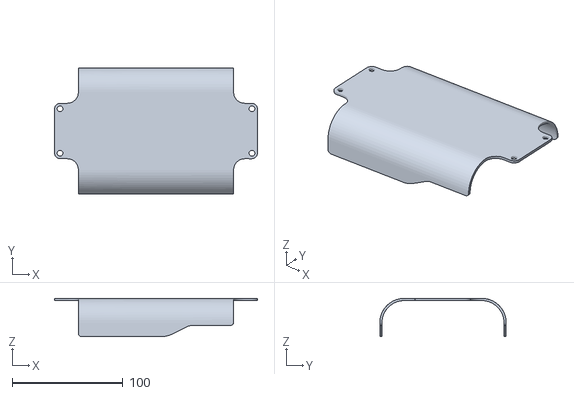
[picture p50: CAD file, 2026-10-31]
3d-viewer/stl/parts/frontpart__0__non-mega_T_cover_cls.stl
183.0 x 114.0 x 34.5
