MrVALIDinfo/Project_Robo_dog/(list of files, cad)

Other CAD files:
3d-viewer/stl/parts/mainbody__4__non-mega_L_side_plate.stl
3d-viewer/stl/parts/mainbody__3__O_shoulder.stl
3d-viewer/stl/parts/mainbody__1__I_shoulder_cls.stl
3d-viewer/stl/kdy/backpart_alatoo.stl
3d-viewer/stl/kdy/rarm.stl
print/kdy/R_arm_cls_cable.stl
3d-viewer/stl/kdy/larm.stl
print/backpart_alatoo.stl
print/kdy/plate_plain.stl
3d-viewer/stl/kdy/rshoulder.stl
3d-viewer/stl/parts/rshoulder__0__R_arm_joint_cls.stl
3d-viewer/stl/parts/larm_cover__0__L_arm_cover.stl
3d-viewer/stl/kdy/larm_cover.stl
3d-viewer/stl/parts/rarm__0__R_arm_cls_cable.stl
3d-viewer/stl/kdy/backpart.stl
3d-viewer/stl/kdy/lfoot.stl
3d-viewer/stl/parts/larm__0__L_arm_cls_cable.stl
3d-viewer/stl/parts/backpart__1__R_cover.stl
3d-viewer/stl/parts/lshoulder__0__L_arm_joint_cls.stl
