MrVALIDinfo/Project_Robo_dog/print/README.md

# Печать

PLA или PETG, слой 0.2 мм, 3 периметра, заполнение 30 %.

| Файл в `kdy/` | Сколько |
|---|---|
| `L_arm_cls_cable`, `R_arm_cls_cable` | 2 + 2 |
| `L_wrist_cls`, `R_wrist_cls` | 2 + 2 |
| `foot` | 4 |
| `L_arm_joint_cls_for_shoulder_reinforcement` | 4 (2 зеркально) |
| `L_arm_cover_for_shoulder_reinfrocement` | 4 (2 зеркально) |
| `shoulder_reinforcement` | 4 (2 зеркально) |
| `I_shoulder_cls`, `O_shoulder` | 2 + 2 |
| `non-mega_L_side_plate`, `R_side_plate` | 1 + 1 |
| `non-mega_T_cover_cls`, `non-mega_B_cover_cls`, `F_cover` | по 1 |
| `plate_plain`, `raspberry_pi_platform`, `servo_board_platform` | по 1 |

И ещё 2 детали из этой папки: `R_cover_alatoo.stl` (задняя крышка) и `cam_mount.stl` (кронштейн камеры).
