MrVALIDinfo/Project_Robo_dog/CHANGELOG.md

# Изменения

- **v2.7** — реалистичный поворот, страница не зависает при загрузке
- **v2.6** — длины болтов по нашим деталям, список закупки исправлен
- **v2.5** — правильный порядок разборки
- **v2.4** — взрыв-схема: разборка до болта
- **v2.3** — картонный макет сверен с деталями
- **v2.2** — кабели серв как настоящие
- **v2.1** — штекеры и удлинители серв
- **v2.0** — итог проверки комплектующих
- **v1.5** — электроника как у mike4192
- **v1.4** — кабели серв по ногам
- **v1.3** — серво в настоящих гнёздах
- **v1.2** — настоящие детали KDY
- **v1.1** — электроника по списку от 23.10
- **v1.0** — первая версия
