MrVALIDinfo/Project_Robo_dog/docs/SpotMicro_dimensions.pdf

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

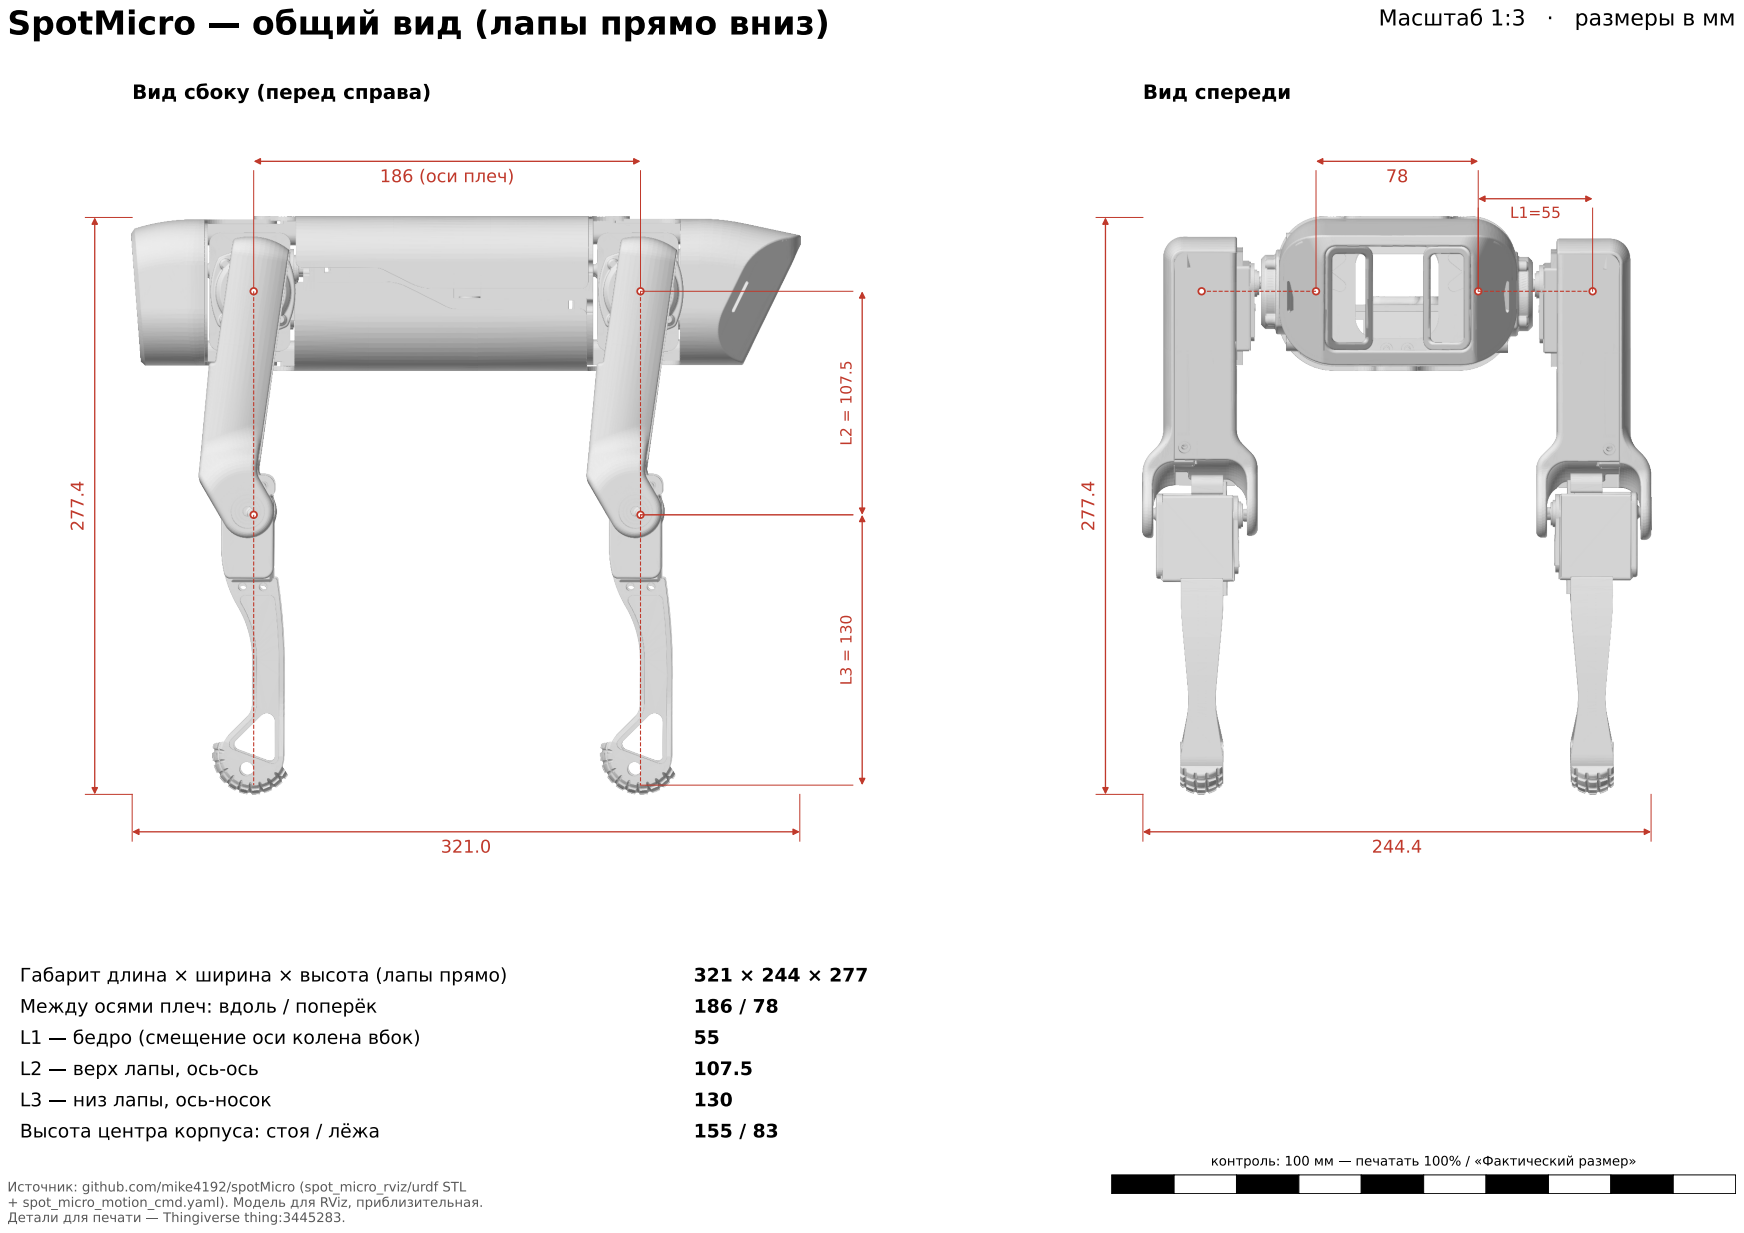
[picture p51: page 1]

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

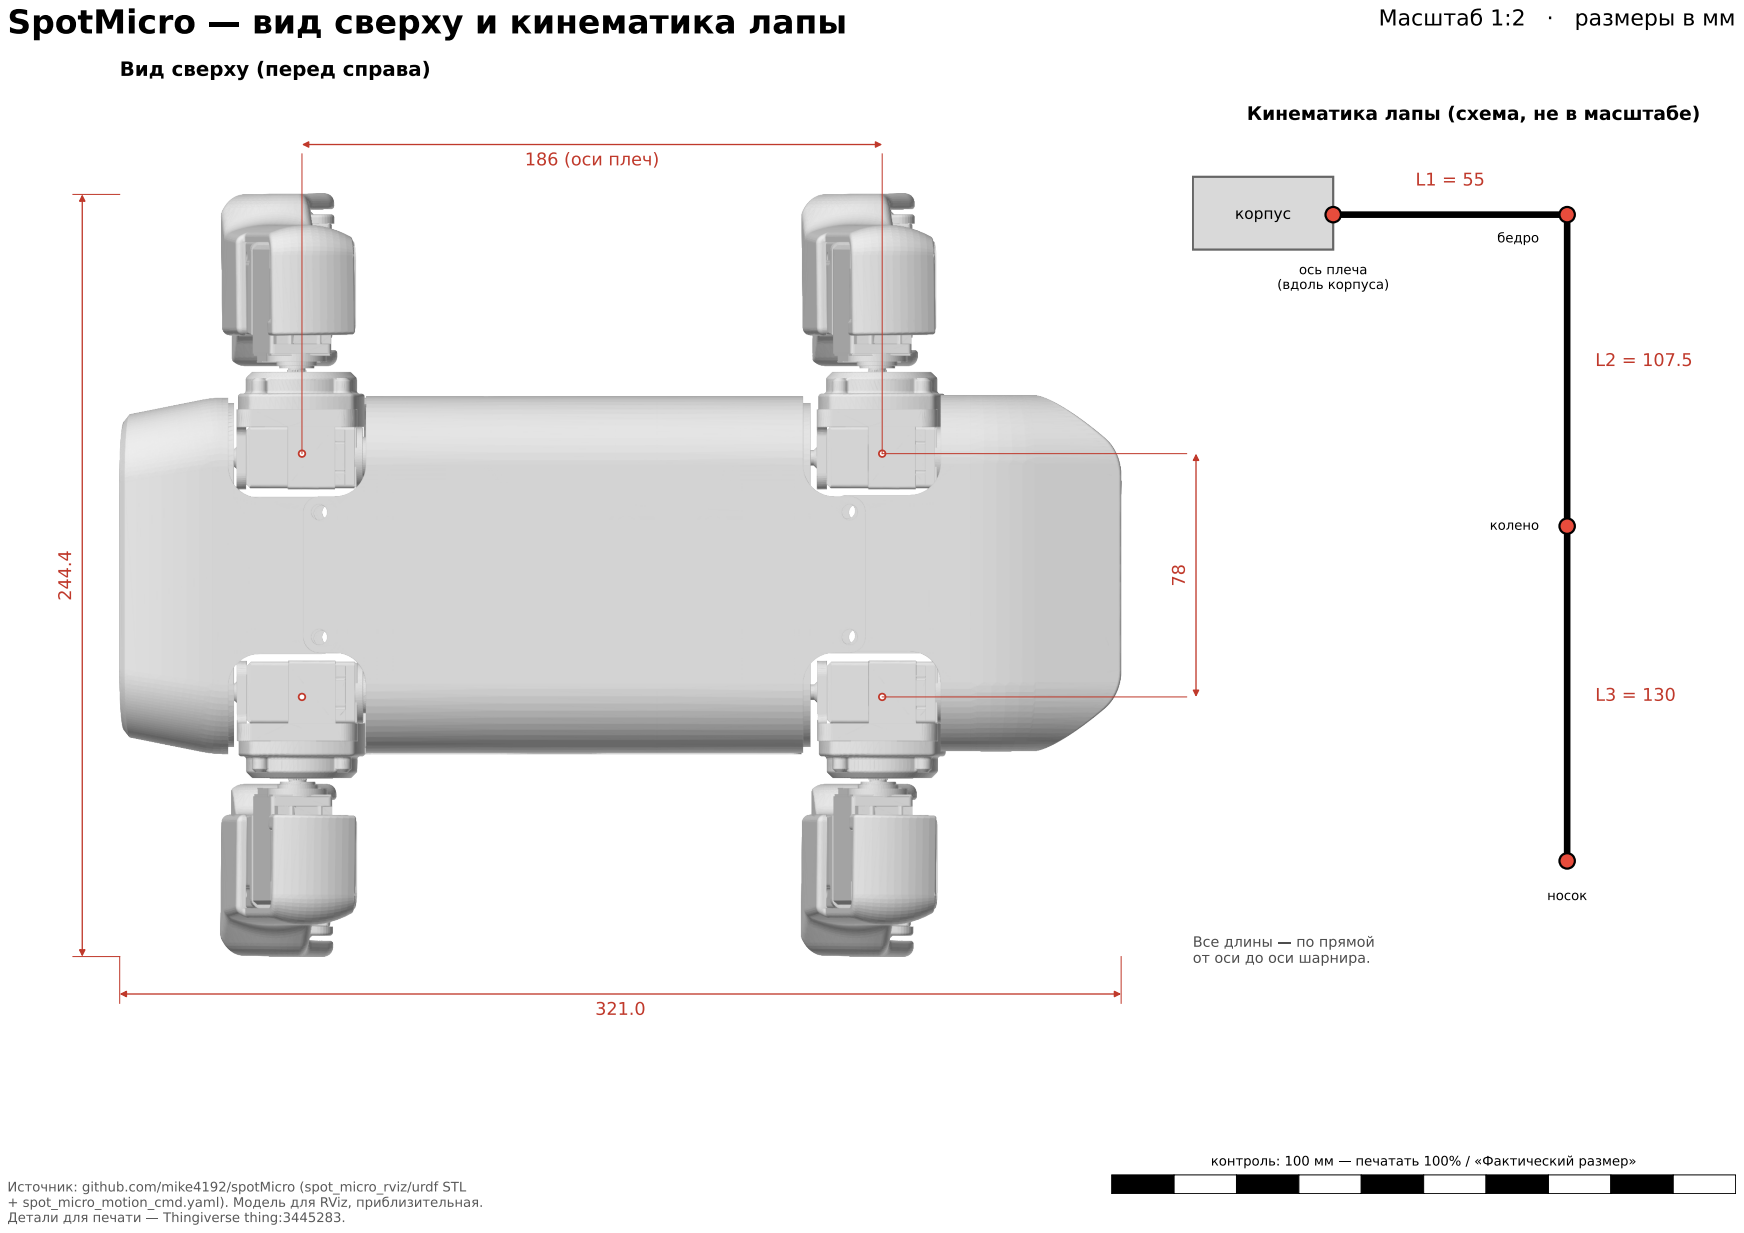
[picture p52: page 2]

SpotMicro | ( | )
: lshoulder.stl · | X × Y × Z = 51.7 × 37.5 × 56.5

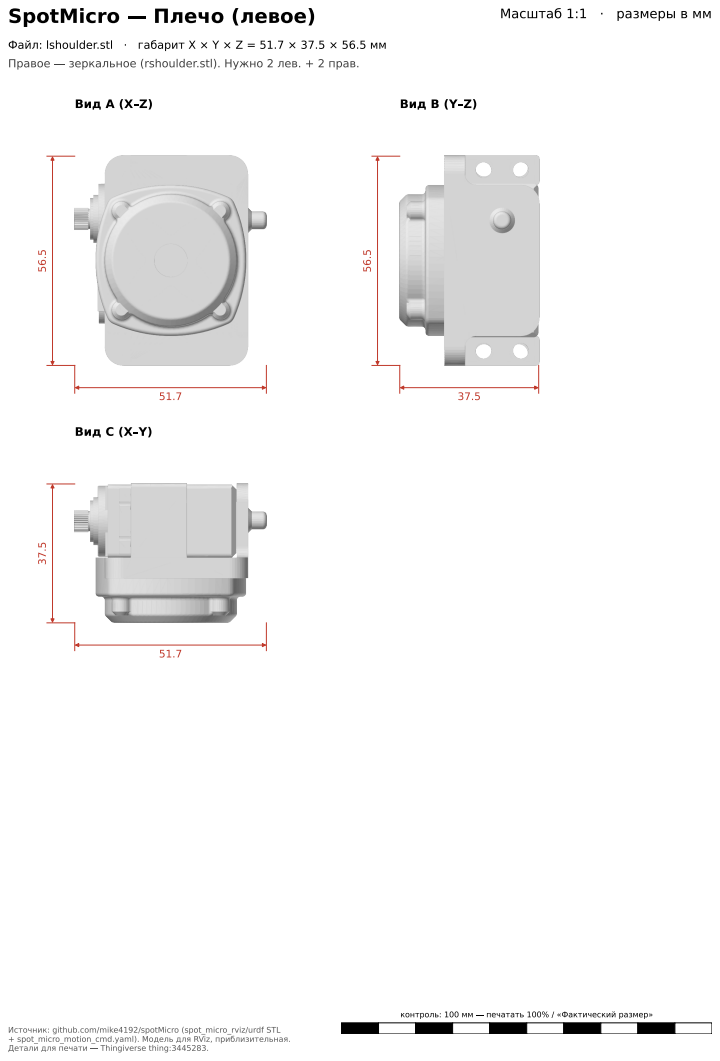
[picture p53: page 3]
+ spot_micro_motion_cmd.yaml).; RViz,; Thingiverse thing:3445283.; (rshoulder.stl).

: github.com/mike4192/spotMicro (spot_micro_rviz/urdf STL

: larm.stl · | X × Y × Z = 38.2 × 60.2 × 137.4
(rarm.stl). | 2 + 2.

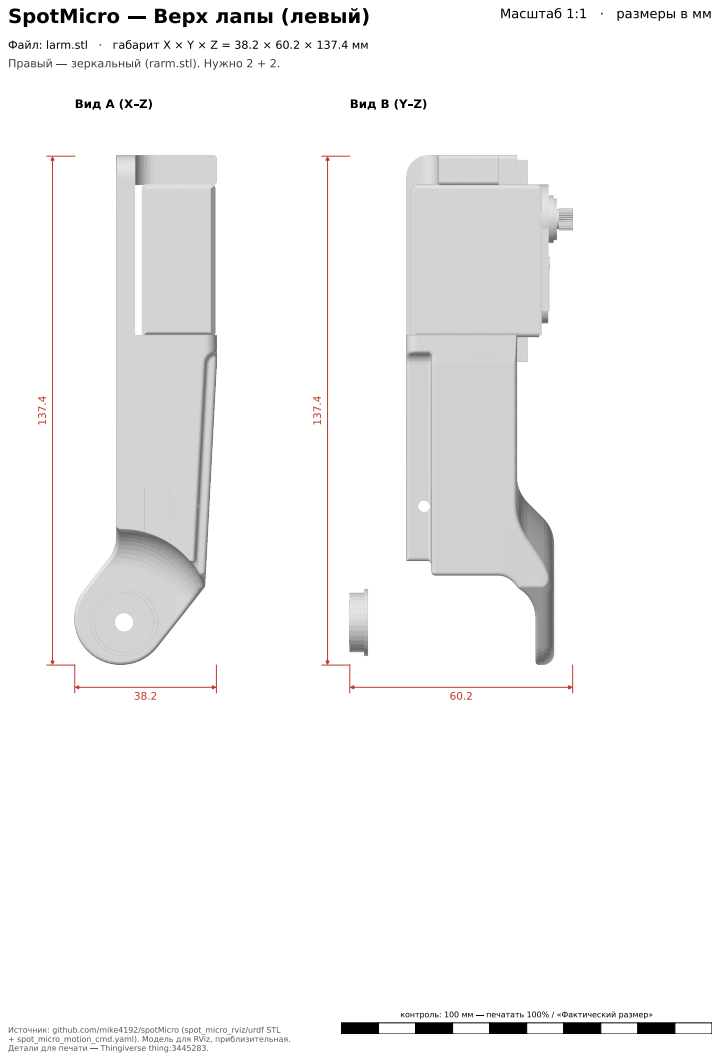
[picture p54: page 4]

: larm_cover.stl · | X × Y × Z = 41.0 × 45.4 × 143.5
(rarm_cover.stl). | 2 + 2.

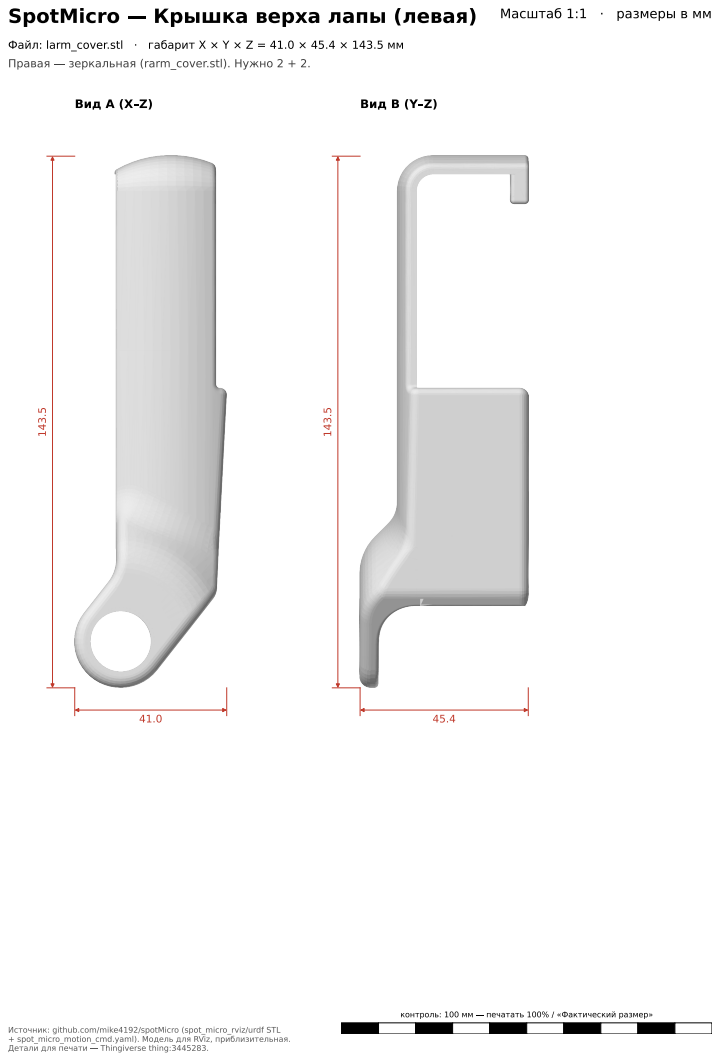
[picture p55: page 5]

: lfoot.stl · | X × Y × Z = 30.4 × 50.7 × 150.0
(rfoot.stl). | 2 + 2.

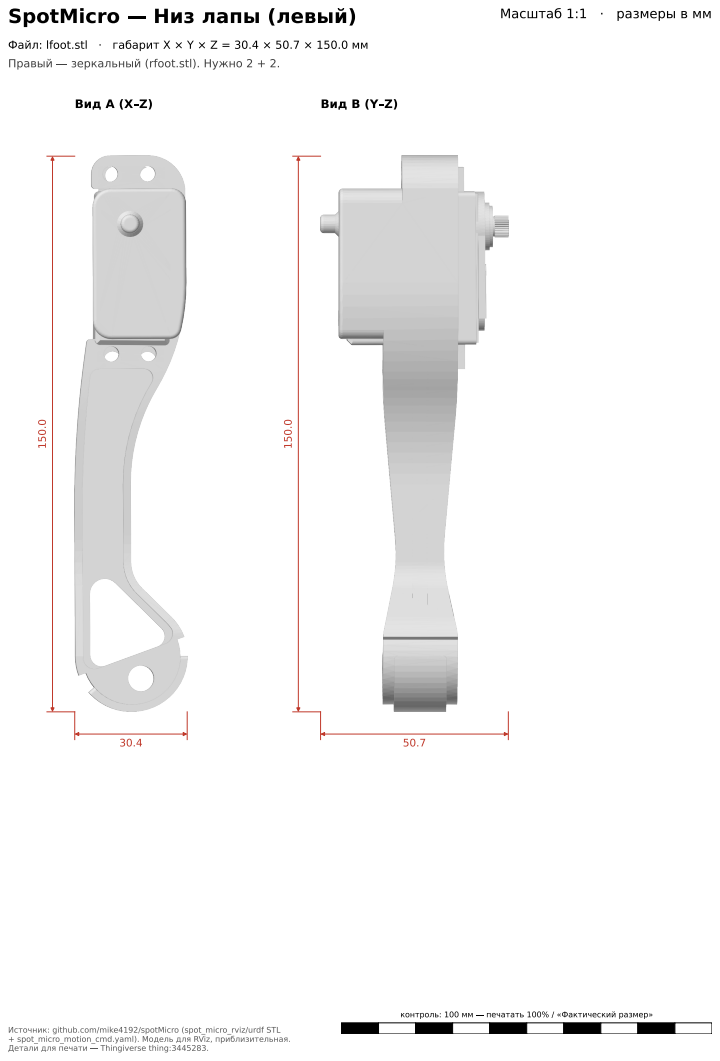
[picture p56: page 6]

SpotMicro | 1:1 ·
: foot.stl · | X × Y × Z = 38.3 × 20.0 × 19.4

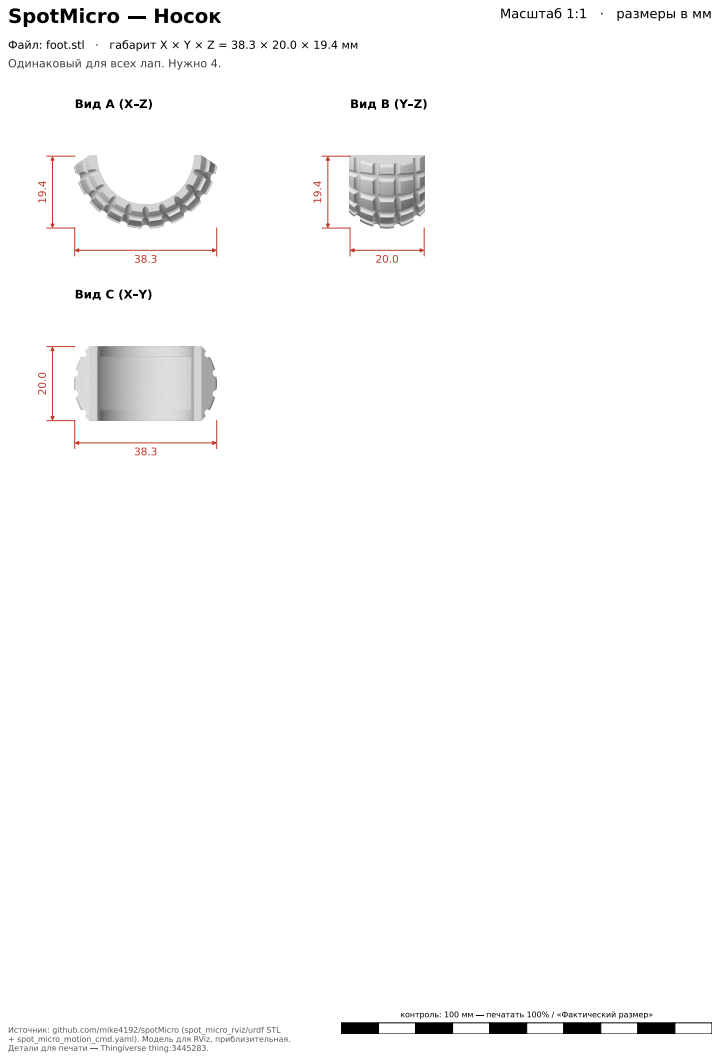
[picture p57: page 7]

SpotMicro | 1:2 ·
: mainbody.stl · | X × Y × Z = 240.7 × 110.0 × 70.4

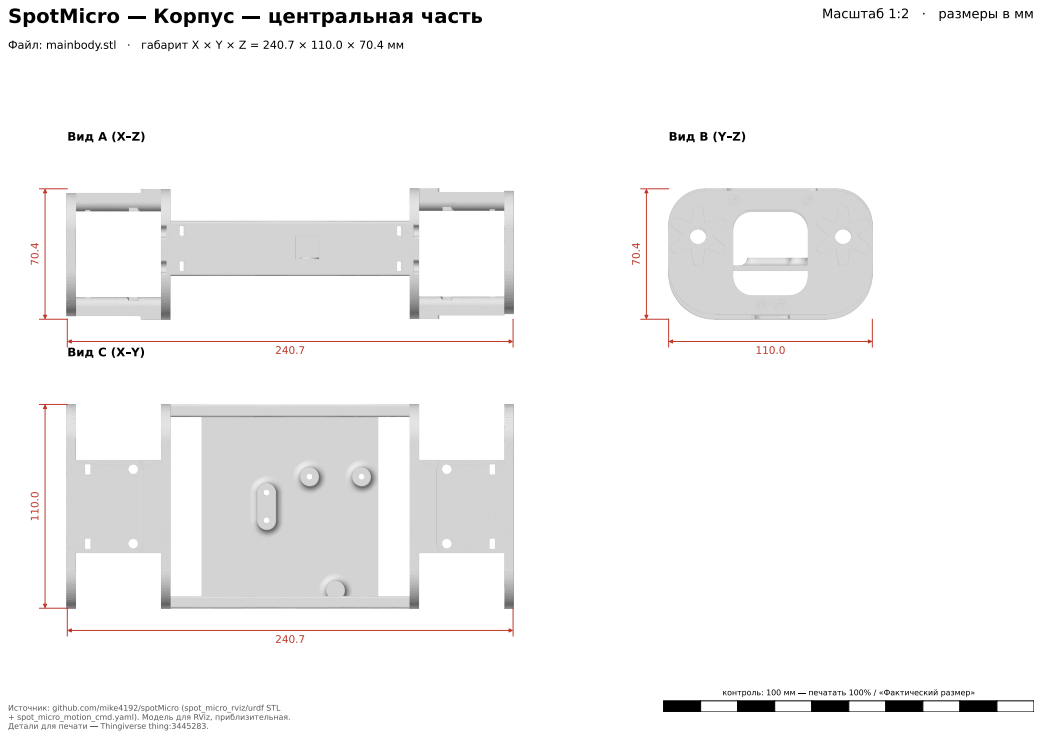
[picture p58: page 8]

SpotMicro | 1:2 ·
: frontpart.stl · | X × Y × Z = 262.0 × 114.5 × 71.2

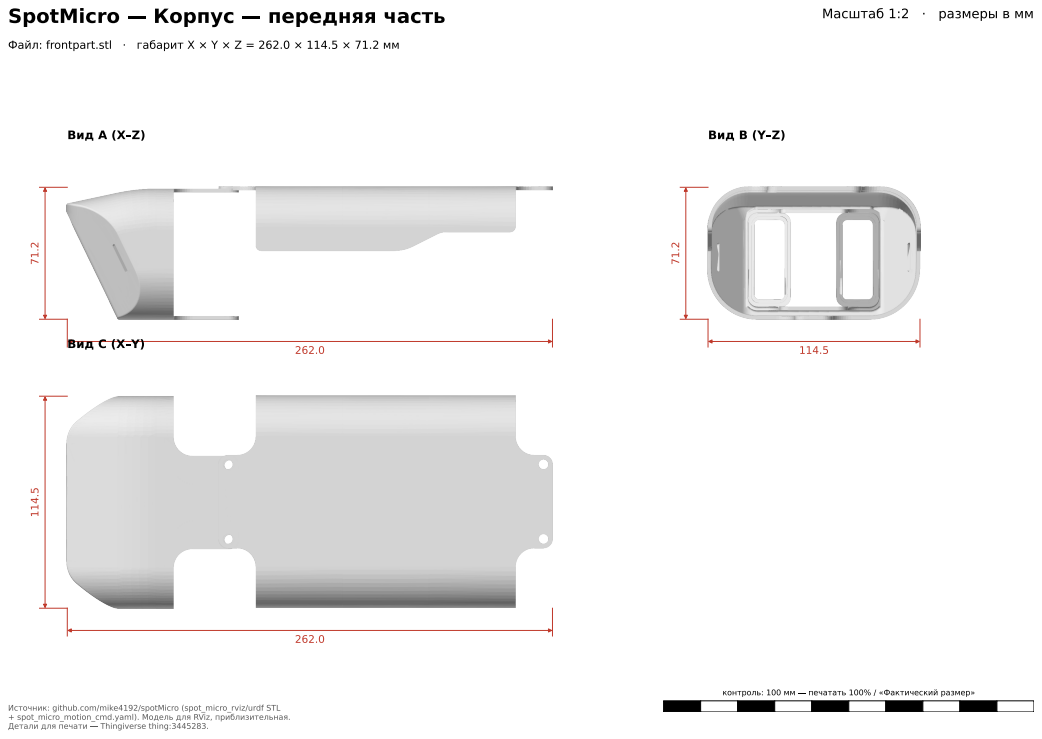
[picture p59: page 9]

SpotMicro | 1:2 ·
: backpart.stl · | X × Y × Z = 238.4 × 114.1 × 72.5

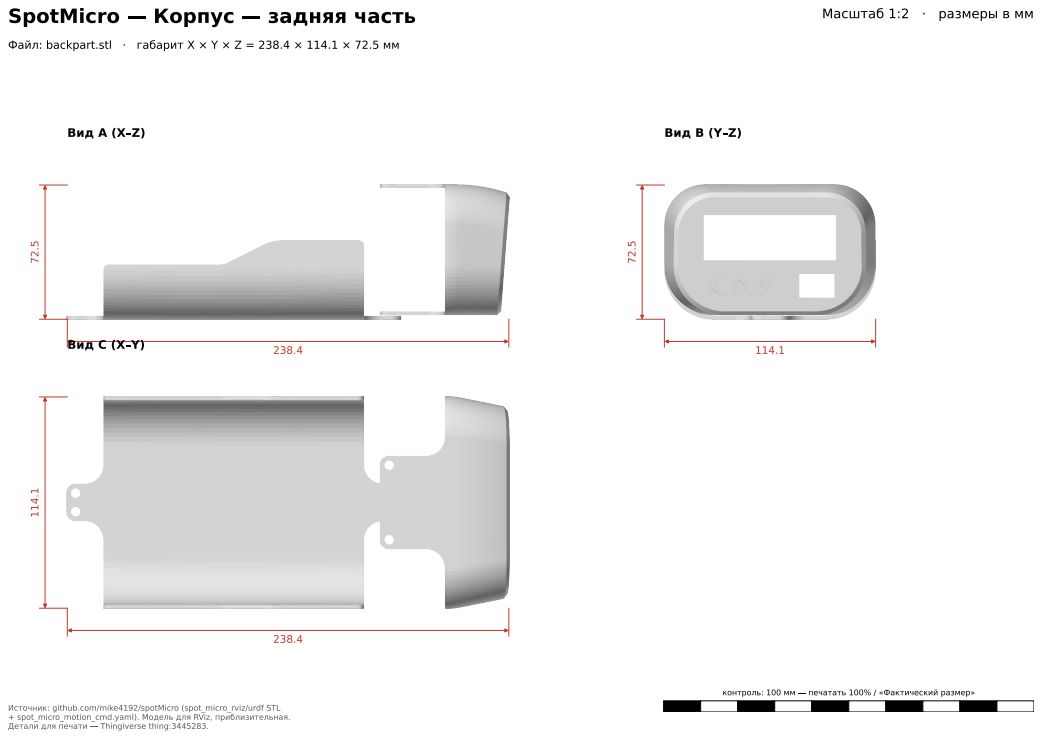
[picture p60: page 10]
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
