MrVALIDinfo/Project_Robo_dog/(commit log)

2026-10-21 Add 3D viewer of the robot dog, Wokwi schematics, docs and tools
    - 3d-viewer: browser 3D model (real Spot Micro STL, electronics per upstream README,
    wiring, logo, WASD walking via inverse kinematics)
    - wokwi: Arduino Mega 12-servo demo and LED+button circuit
    - docs: printable dimensions PDF, circuit picture
    - NOTICE.md: sources and licenses
2026-10-23 Add cardboard 1:1 model: cut templates and assembly manual
    - cardboard/: true-scale cut sheets (A4 with split body parts, A3), A3 SVGs
    for laser cutting, and an 11-step illustrated assembly manual (Russian)
    - tools/cardboard/: generator (tab/slot geometry from the STL silhouettes,
    sheet packing, exploded-view renders); cardboard thickness is a parameter
    - README: list the new folders
2026-10-26 v1.1: parts list from 23.10.2026, fit check, new logo, fixed rear cover
    - 3D viewer: electronics per the new parts list (Pi 3B, PCA9685 + cap,
    MPU-6050, Pi Camera v2, LiPo 2S, XT60, fuse, switch, UBEC, buzzer,
    USB mic/speaker, ADS1115 option); servos seated per bracket STLs
    - Built-in fit check: parts vs body and each other, wires through walls,
    servo cable and camera ribbon lengths, camera view, electrical calc
    - New Ala-Too IT & Business College logo on the top cover
    - Rear cover: K.D.Y engraving filled in the STL, raised ALA-TOO text
    - print/: camera mount and rear cover; tools/mounts, tools/logo generators
    - CHANGELOG.md with v1.0 and v1.1
2026-10-30 v1.2: real KDY0523 print parts in the 3D model
    - The mike4192 URDF meshes turned out to be KDY0523 `_mg` parts plus
    servo bodies (ICP match 0.002 mm); the model now uses the parts we
    actually print: `_cls` (PDI-HV5523MG), non-mega covers and side plate,
    mike4192 plain plate
    - print/kdy: STLs from Thingiverse 3445283, 4591999, 4596267 (CC BY)
    - tools/kdy/fit_kdy.py: part registration and servo seat extraction
    - Rear cover: ALA-TOO text is now on R_cover only; the old
    backpart_alatoo.stl fused the bottom and rear covers into one body
2026-10-30 v1.3: servos seated in the real _cls pockets
    - Servo seats taken from the KDY assembly and refined against the _cls
    parts: the URDF servos were off and intersected the plastic by 12-37 %;
    corrections are within 1 deg and 1.5 mm
    - PDI-HV5523MG fits every _cls pocket with no overlap (0.3-0.5 mm wall gap)
    - Fit check now tests servos against the leg parts, not only the frame
    - tools/kdy/inside.cpp: fast point-in-mesh test used by `fit_kdy.py seats`
2026-10-30 v1.4: servo cables routed along the legs
    - Cable routes from a 2 mm grid path search with 2 mm clearance
    (tools/kdy/cable_routes.py), per side since R_ parts are not exact
    mirrors of L_
    - Knee cable crosses the knee on its axis, hip cable runs along the inner
    side of the thigh, both enter the body through the gap between the
    I_shoulder bulkhead and the shoulder bracket
    - Hip servo end face sits flush to the thigh wall (0-0.45 mm), so the
    printed thigh gets a 2x5.6 mm cable groove: print/kdy/*_arm_cls_cable.stl
    - Fit check now tests servo cables in 7 poses against frame and legs
    - Real route lengths: extension leads needed on 8 of 12 servos
2026-10-30 v1.5: electronics on mike4192 platforms, shorty battery, RF1 switch
    - Plain plate plus printed Raspberry Pi and PCA9685 platforms on
    double-sided tape, as in the mike4192 build: no drilling of the Mega plate
    - Battery: 2S 4000 mAh shorty (e.g. Reedy #306, 94x47x25.1 mm)
    - Switch: Switch Components RF1-1A-DC, 16 A at 12 V DC, 19.2x13.0 cutout
    - Servo extension lead connectors shown on the cable routes and reported
    (4 of 8 inside the body, 4 near the shoulders - tie them down)
2026-10-30 v2.0: final check write-up, print list, corrected assessments
    - README: what to buy or replace, what fits as is, what the real parts
    revealed; full print list with quantities in print/README.md
    - Assessments corrected against the mike4192 build (same parts, robot
    walks): servo power through PCA9685 and a 5 V LCD without a level
    shifter work - a risk and out of spec, not a blocker
    - mike4192 shoulder reinforcement recommended; its bracket and thigh
    cover match the standard parts' envelope
2026-10-30 v2.1: servo plugs on the PCA9685 header, extension joints sized per route
    - 12 servo plugs on the PCA9685 header; wires leave from their tops
    - Extension joint drawn as a female/male connector pair along the cable,
    tooltip shows the extension length and distance to the board
    - Extension length picked per route: 10 cm for hips (joint lands 2-7 cm
    from the board), 20-30 cm for knees
2026-10-30 v2.2: realistic servo cables
    - Routes straightened by line of sight (3-7 straight runs instead of the
    2 mm grid staircase); shorter, extension leads needed on 6 of 12 servos
    - Servo cable drawn as a flat three-wire ribbon without twist, bends
    rounded, zip ties where the cable is fixed to the thigh, shin and
    shoulder bracket
    - Cable check samples the centreline every 2 mm (was ~8 mm, chords cut
    corners); triangle grid in check.js keeps it fast
2026-10-30 v2.3: cardboard model matched to the real KDY parts
    - Side profiles already matched, widths did not: thigh plates were at
    y 73-107 instead of 77-112 (hip axis y = 94), shin 79-101 instead of
    83-103; leg plates moved to the real planes
    - Washers fill the gaps (knee 5, hip 2), skewers sized from the width:
    axle 23.4 cm, knee 4.5 cm; dog width 23 cm
    - Automatic cardboard check: plates, washers and spacers clear in five poses
    - Manual: sizes, part count (94), skewer lengths and washer codes come
    from the geometry; notes that the cardboard shoulder does not rotate
2026-10-31 docs: final parts list and wiring (PDF)
    Replaces the 23 Oct list: 6 servo extensions instead of 12, shorty LiPo
    (Reedy #306 is discontinued), RF1-1A-DC-2-B switch with a 15 A fuse,
    self-tapping screws for the Pi/PCA9685 platforms, hot glue for servo horns,
    I2C level shifter for the 5 V LCD, UBEC output at 5.0 V.
2026-10-31 v2.4: exploded assembly view
    Assembly/disassembly animation in the 3D viewer (button or ?explode):
    bolts unscrew, covers and side plates fly off, legs split into parts,
    electronics rise in layers, callout labels when exploded.
    Body split back into the 11 print parts; fasteners placed at holes
    found in the parts (M4 48 + 48 nuts, M5 8, M3 36). ALA-TOO lettering
    is now part of the rear cover mesh. New lighting (key/fill/rim, env
    reflections, ACES, contact shadow); fewer meshes and wire rebuilds.
2026-10-31 v2.5: realistic disassembly order
    Each fastener finds the parts it clamps (hole-wall vertices along its
    axis) and unscrews right before they separate, then travels with the
    head-side part. Order: cover bolts, covers, legs, leg and inner bolts,
    side plates/bulkheads/electronics/leg parts; assembly is the reverse.
    Side plates fly to their own side; bolts and logo float with their part.
2026-10-31 v2.6: bolt lengths from the assembly geometry
    Each bolt is ray-checked along its axis through all parts and servo ears
    (material, nut slots, blind ends). For our _cls/non-mega parts: 8 M5x15
    + 8 M5 nuts, 40 M4x20 + 8 M4x25 + 48 M4 nuts, 24 M3x25 + 12 M3x20 +
    36 M3 nuts. KDY's BOM (for _mg parts) differs. Animation, purchase list
    and README updated.
2026-10-31 v2.7: planted-foot turning, no freeze on load
    Turning in place keeps stance feet on the floor and rotates them about
    the body centre with shoulder abduction in the leg IK; body yaw follows
    the feet. Collision check runs in chunks with the dog kept in its live
    pose between chunks; bolt-to-part joins are precomputed in explode.json.
2026-10-31 Real Raspberry Pi 3 model, GLB export and Blender render of the disassembly
    Pi 3 B from Thingiverse 1701186 (CC BY-SA), coloured by board zones; the
    old boxes stay as invisible proxies for the fit check. ?exportglb writes
    the scene with the disassembly animation to GLB; tools/explode/
    blender_render.py renders it in EEVEE with studio lighting.
